shetnehal/Chipalooza_CuriousIC_BMS/presentation/Design review slides of BMS.pptx

## Battery Management System - AFE Design Review

Team CuriousIC

## System Architecture

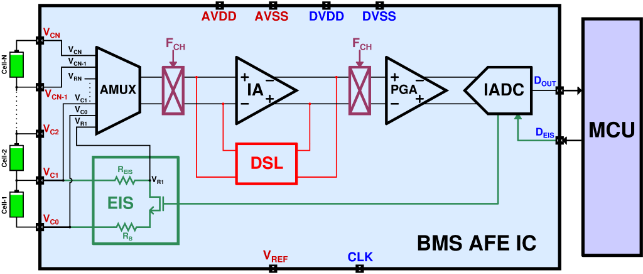
[picture p1: figure]

- Capacitively-Coupled Instrumentation Amplifier (CCIA) { Chopper, DC Servo Loop (DCSL) }
- Incremental Delta-Sigma (DSM) Analog-to-Digital Converter (ADC) { DSM Loop, Clock Generation}

## Top-Level System Schematic

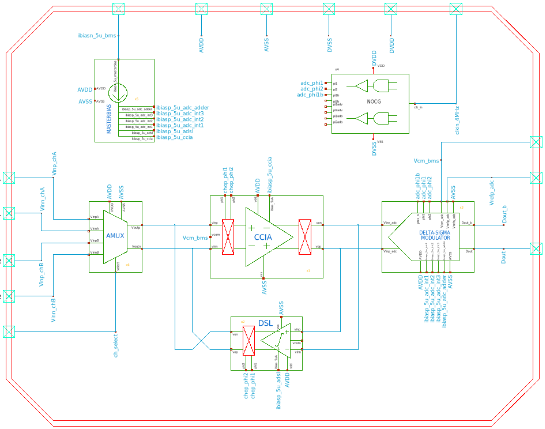
[picture p2: figure]

## ADC Specifications

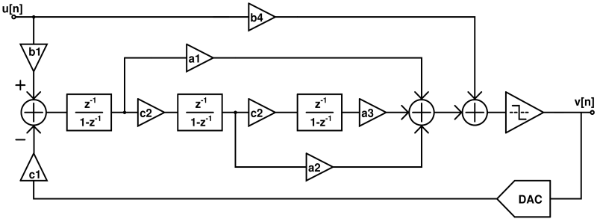
[picture p3: figure]

- Cascade of Integrators with Feed Forward (CIFF) architecture
- State reset after each conversion after each conversion enables sequential multi-cell measurement in BMS AFE

Parameter | Details
Order | 3rd
ENOB | > 16 bits
Sampling Frequency | 4MHz
Signal Bandwidth | 3.9kHz
OSR | 512
Quantizer | 1-bit

## ADC Schematics

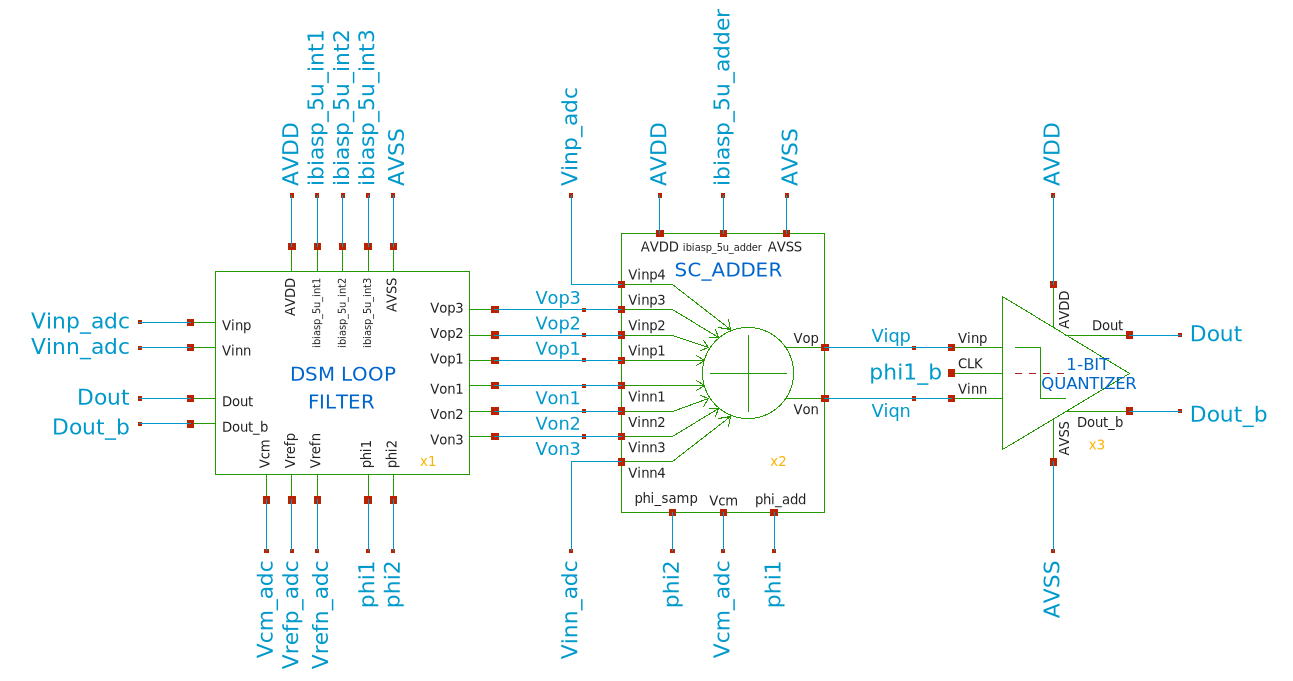
[picture p4: figure]

- The 3rd-order Delta-Sigma ADC employs a cascaded three-stage loop filter.
- A switched-capacitor (SC) analog adder combines the outputs of the integrators.
- A 1-bit quantizer converts the summed analog signal into a digital output.

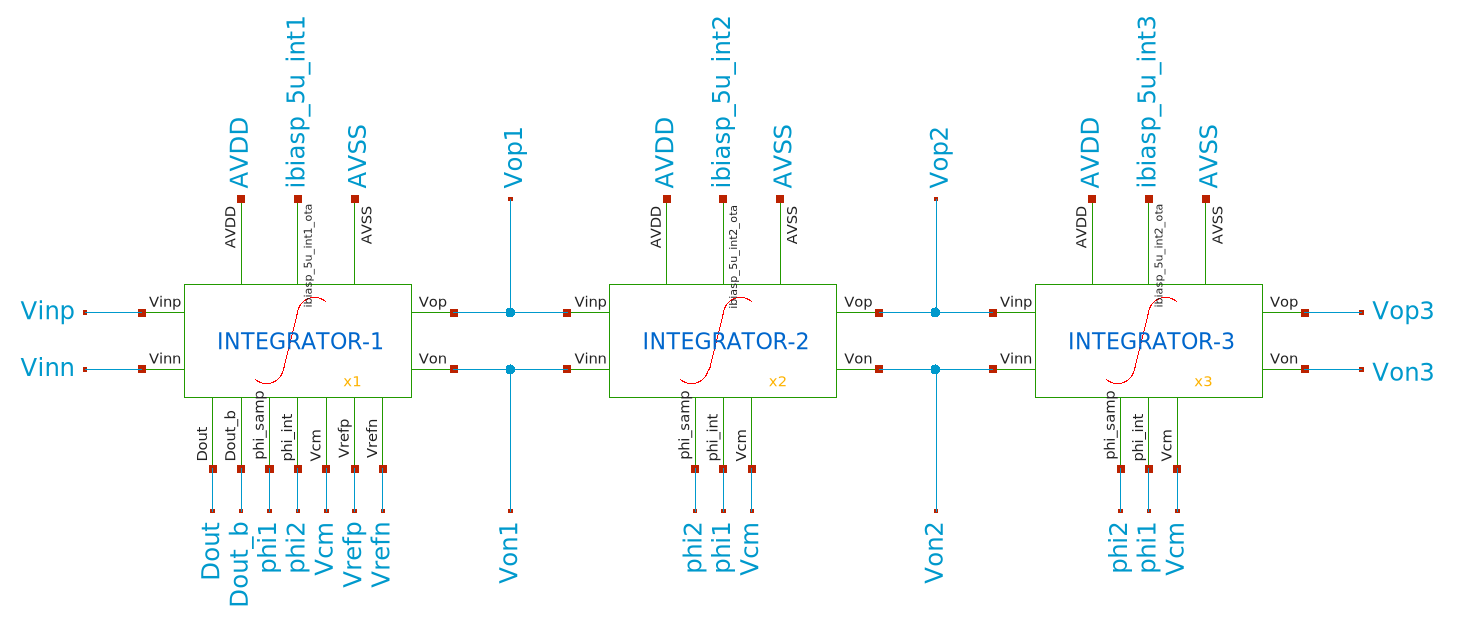
[picture p5: figure]

## ADC Schematics

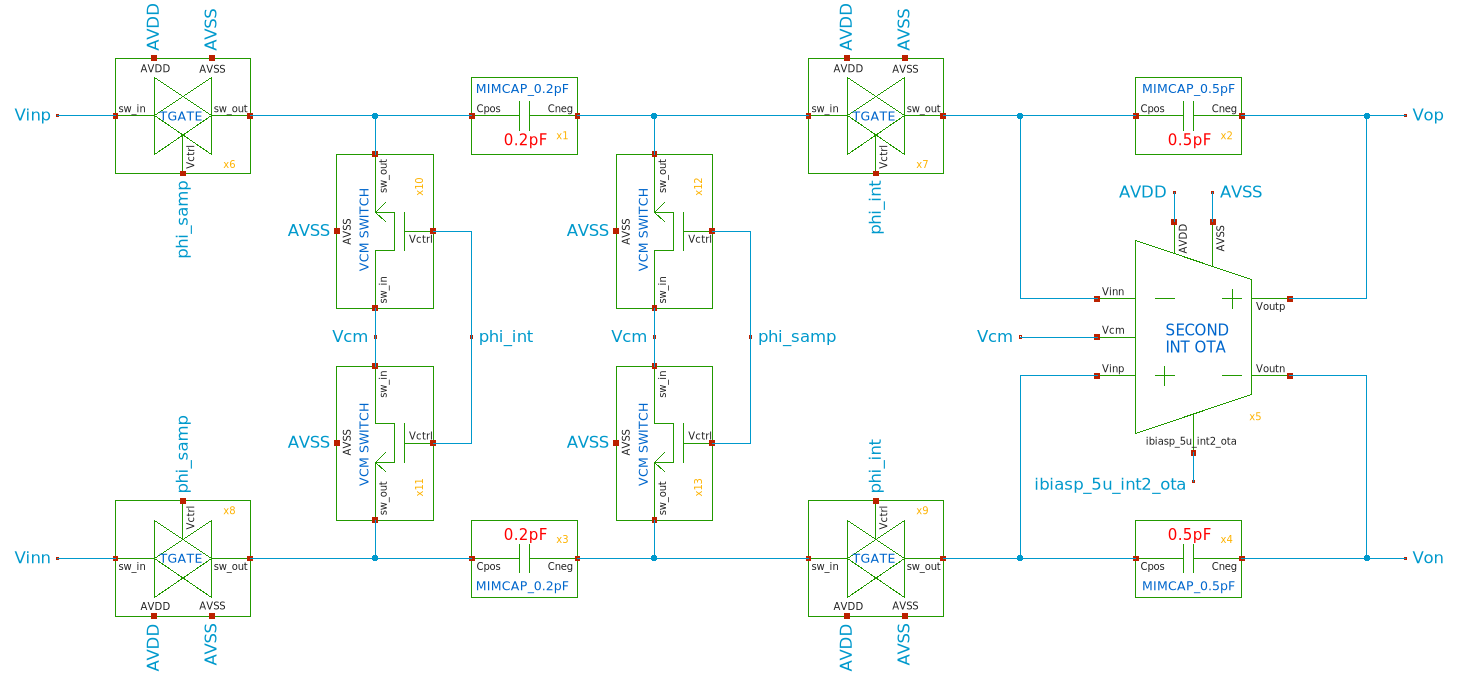
[picture p6: figure]
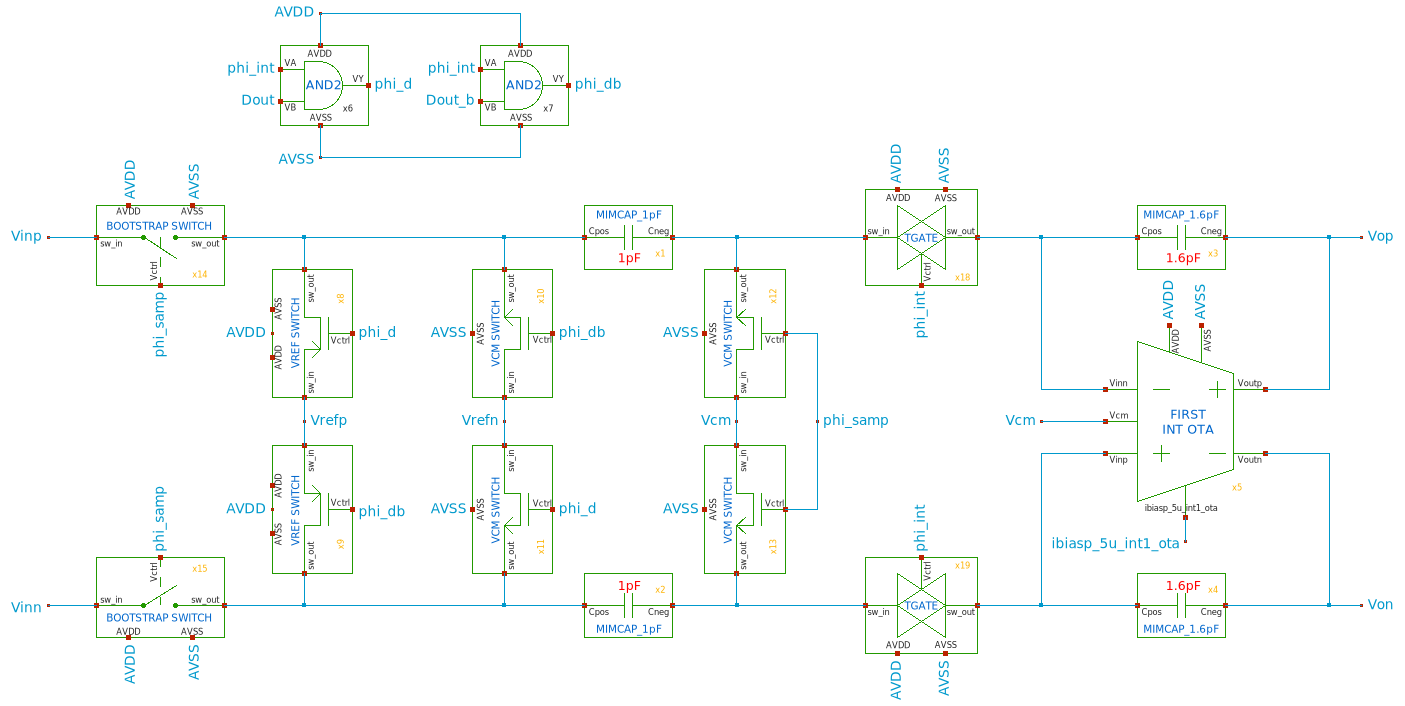
[picture p7: figure]

2nd Integrator

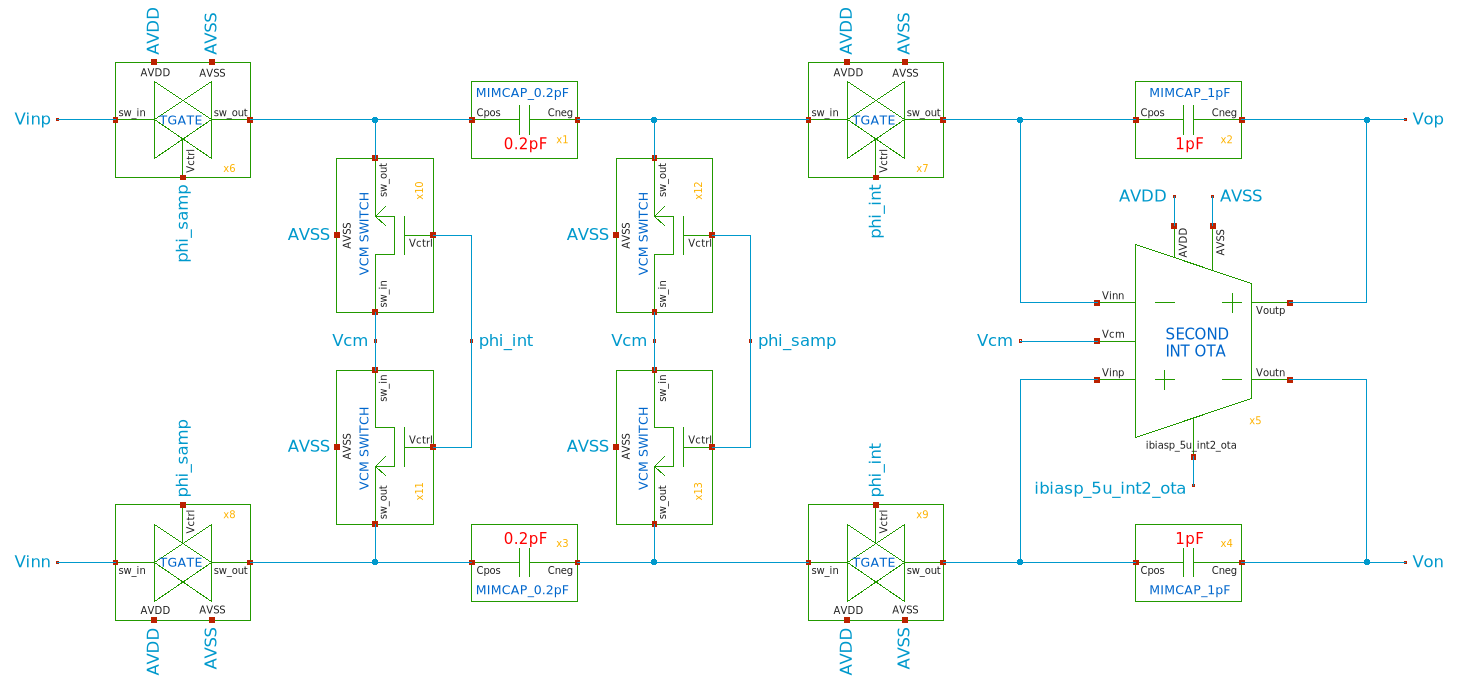
[picture p8: figure]

1st Integrator

3rd Integrator

- Schematics of Integrators used in the DSM Loop Filter

## ADC Schematics

OTA for 2nd Integrator

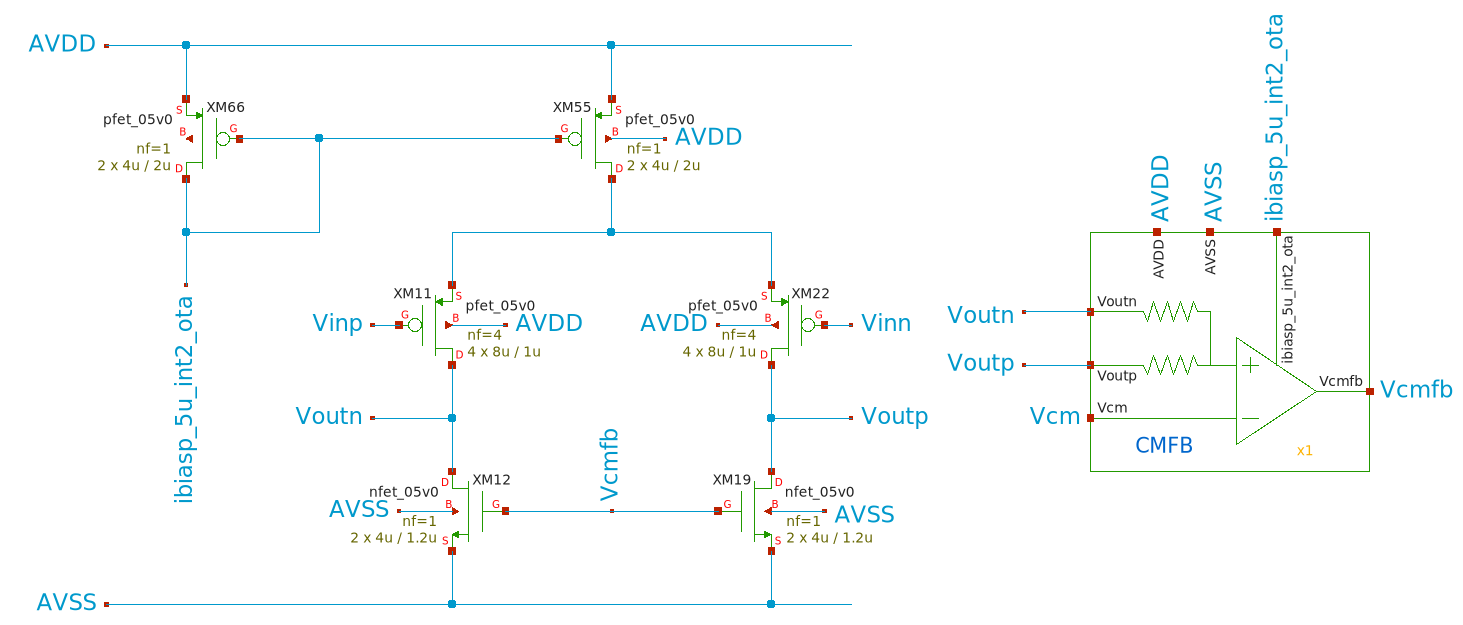
[picture p9: figure]
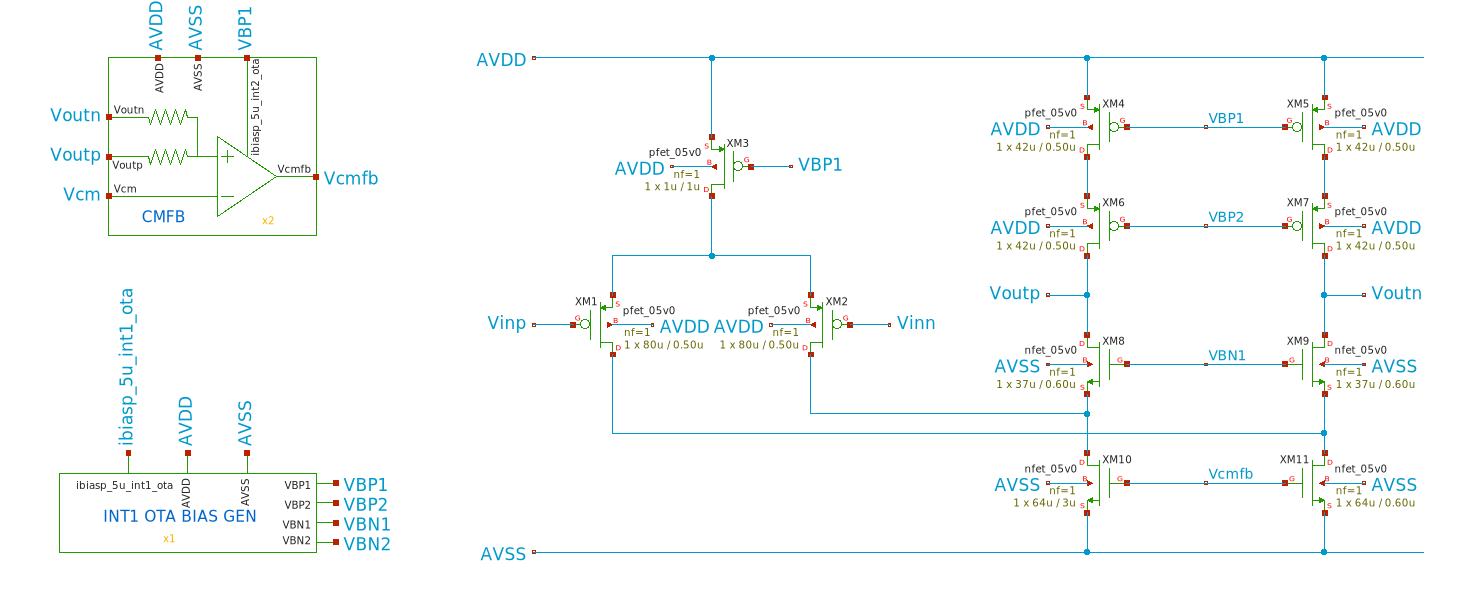
[picture p10: figure]

CMFB circuit for both OTA

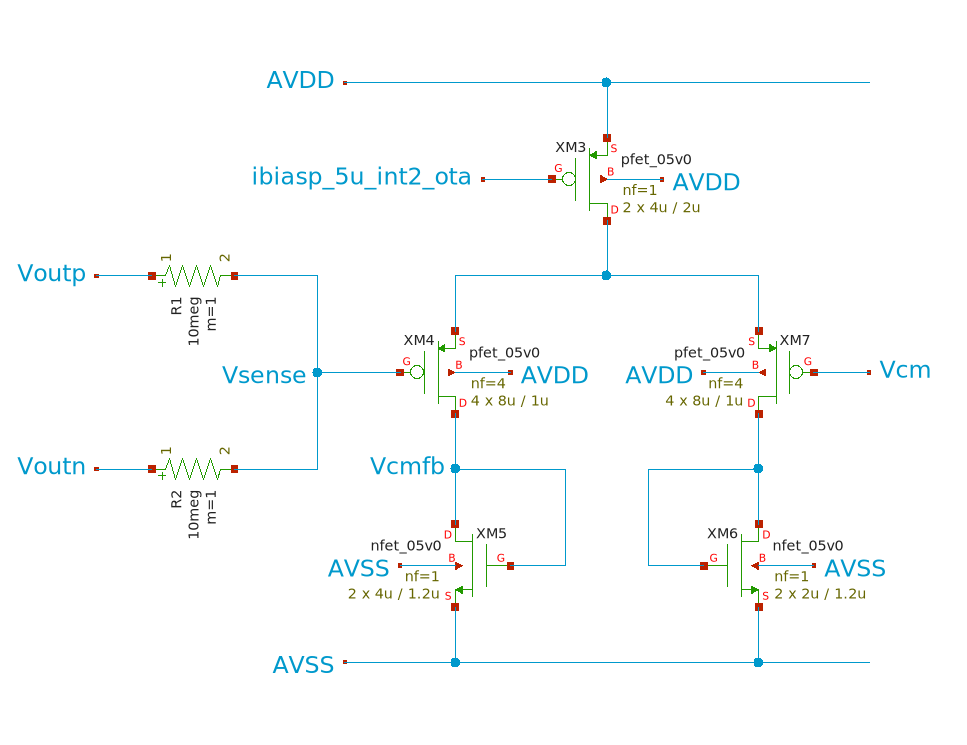
[picture p11: figure]

OTA for 1st Integrator

- Schematics of the OTAs for designing integrators
- Common Mode Feedback (CMFB) is reused for both OTAs

## ADC Simulation Results

1st Integrator Output

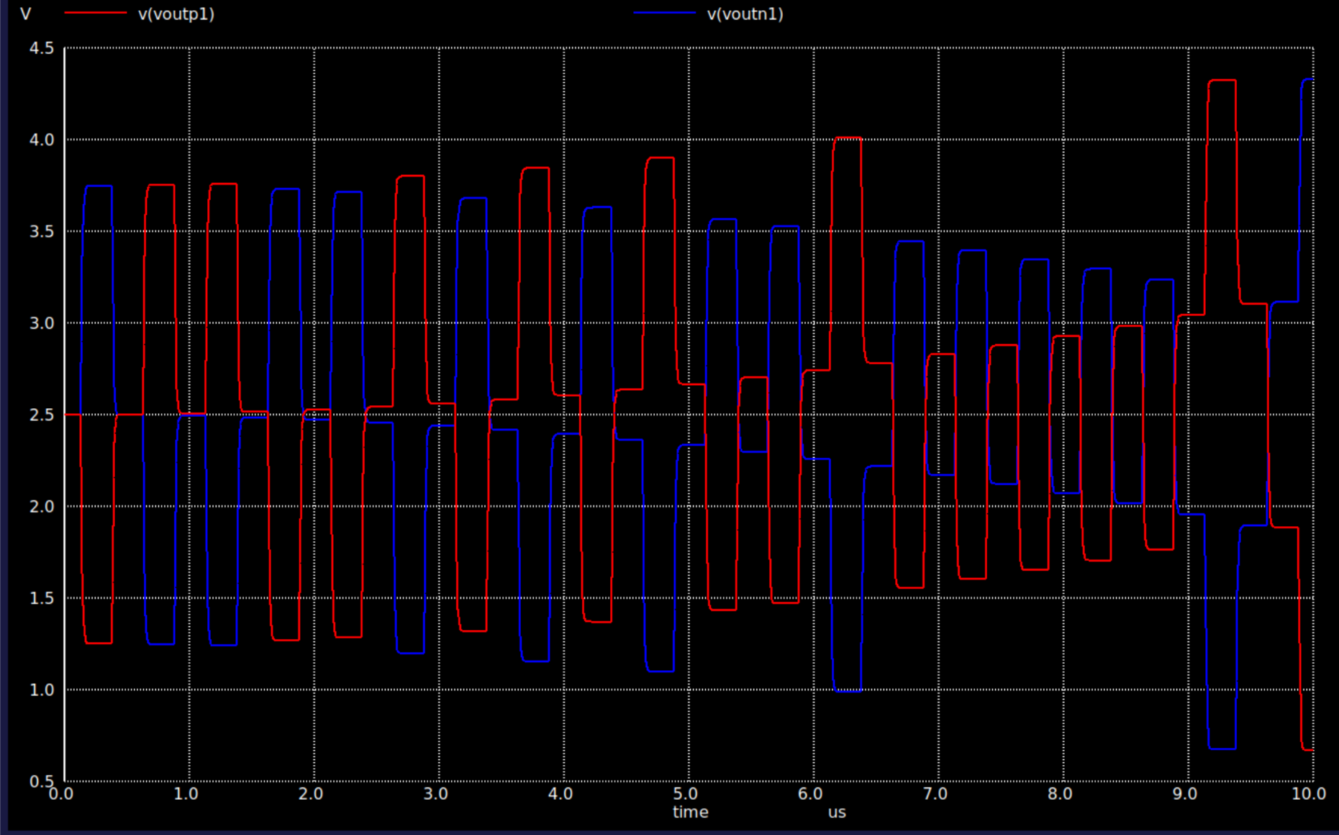
[picture p12: figure]

2nd Integrator Output

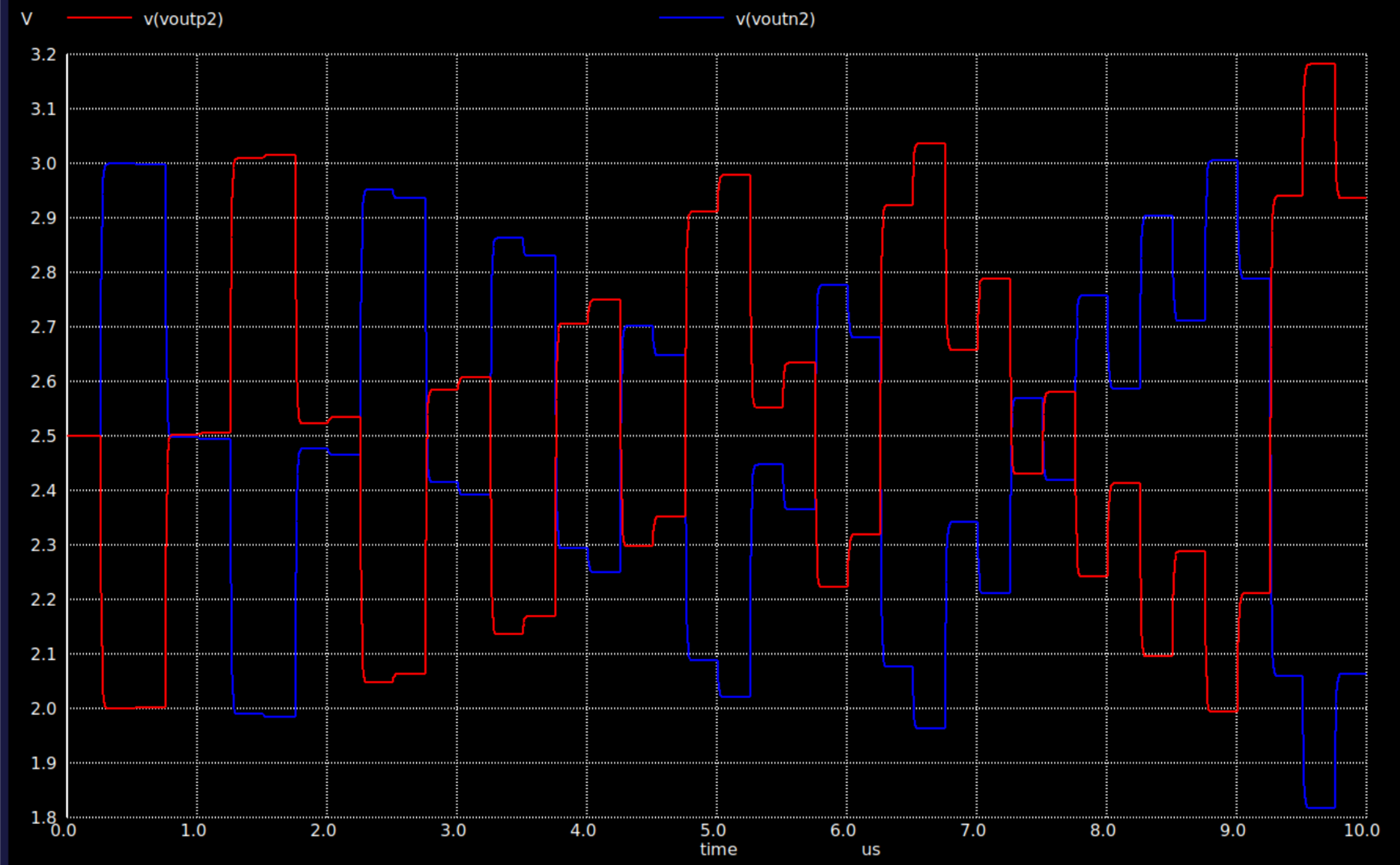
[picture p13: figure]

- The integrator stage outputs exhibit stable bounded behaviour with progressively reduced signal swing across successive stages, indicating proper loop operation and effective higher-order noise shaping

## ADC Simulation Results

3rd Integrator Output

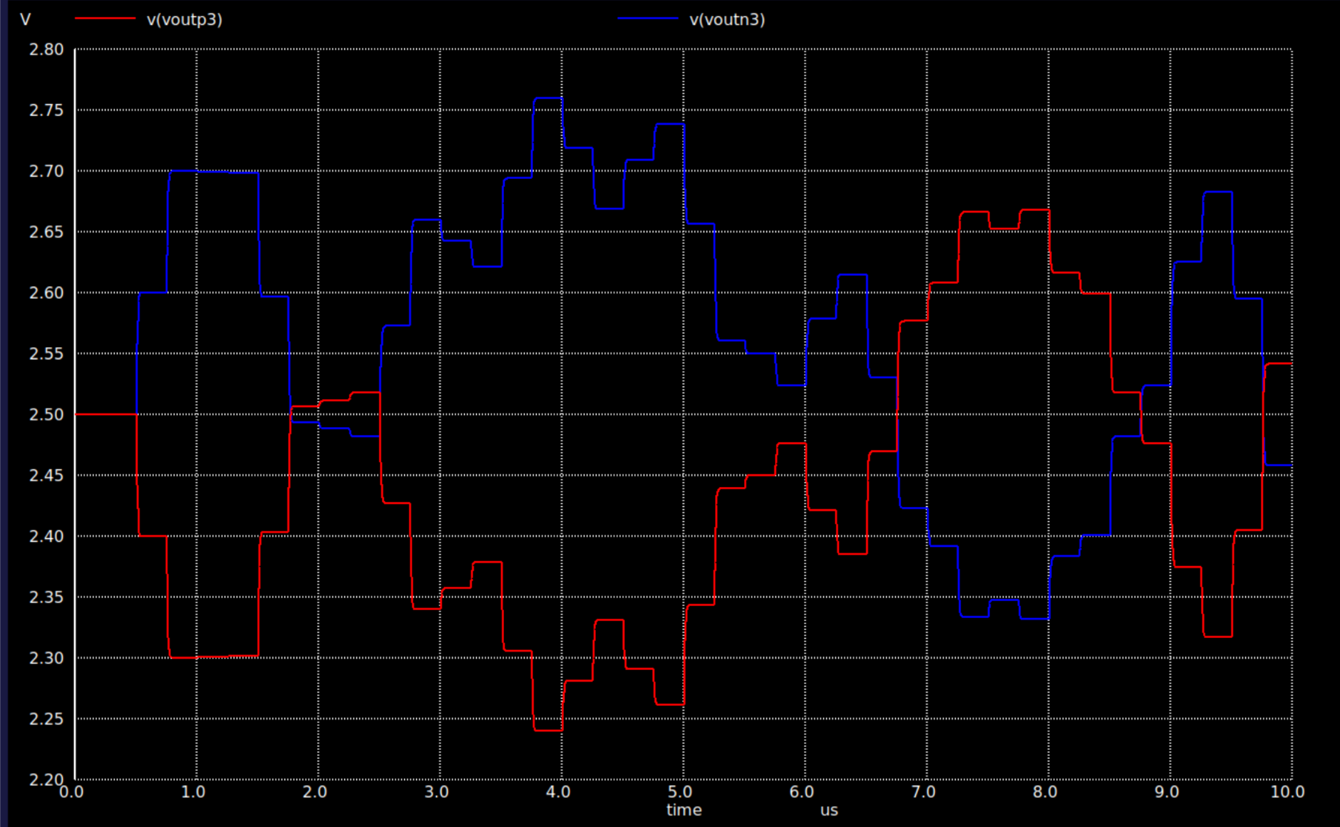
[picture p14: figure]

Quantizer Output

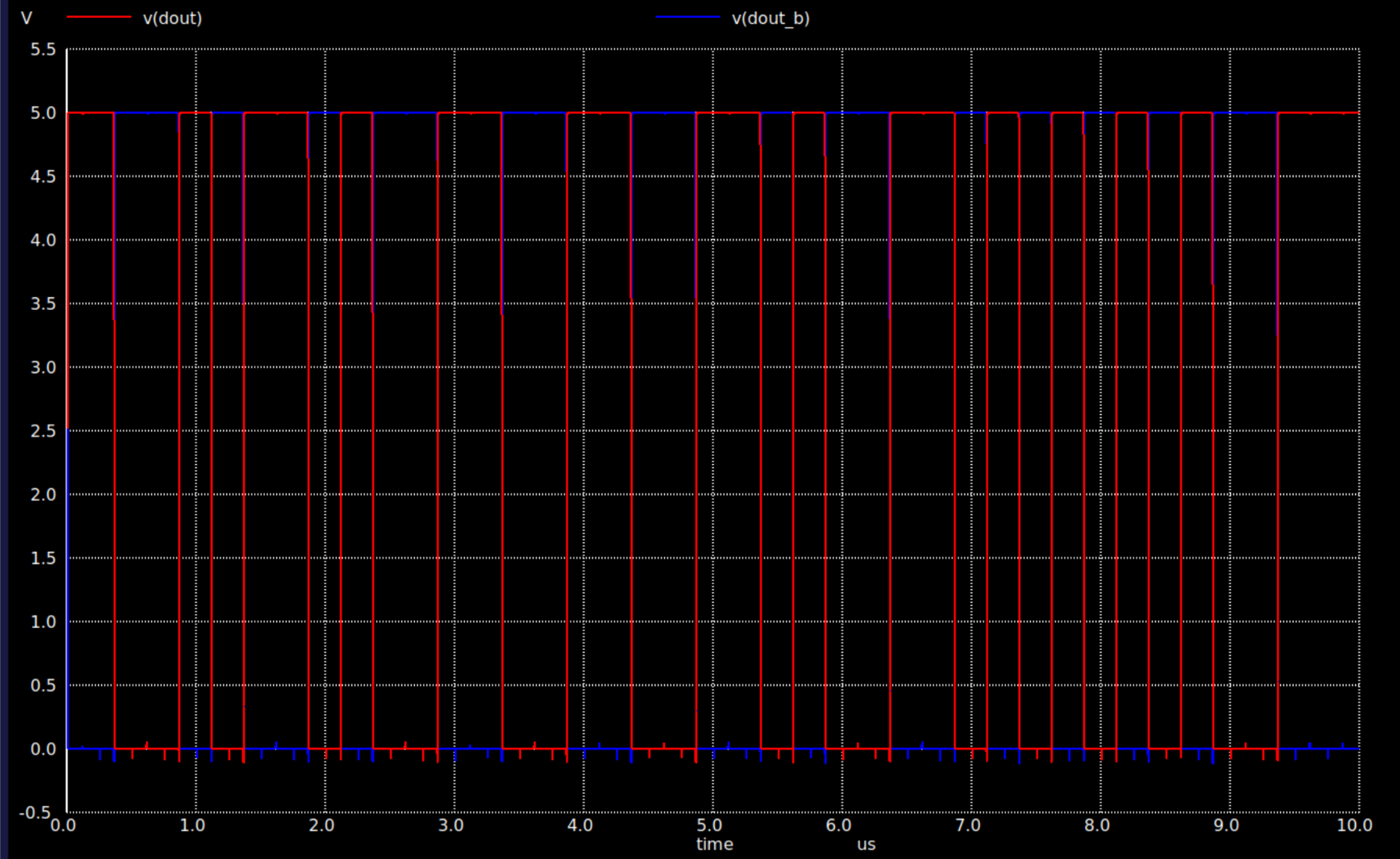
[picture p15: figure]

- The third integrator output remains bounded throughout the simulation, demonstrating stable third-order loop dynamics while accumulating and shaping the quantization error
- The 1-bit quantizer produces a binary bitstream that switches between the two output levels according to the input signal amplitude. The varying pulse density encodes the analog input while enabling high-order noise shaping

## ADC Simulation Results

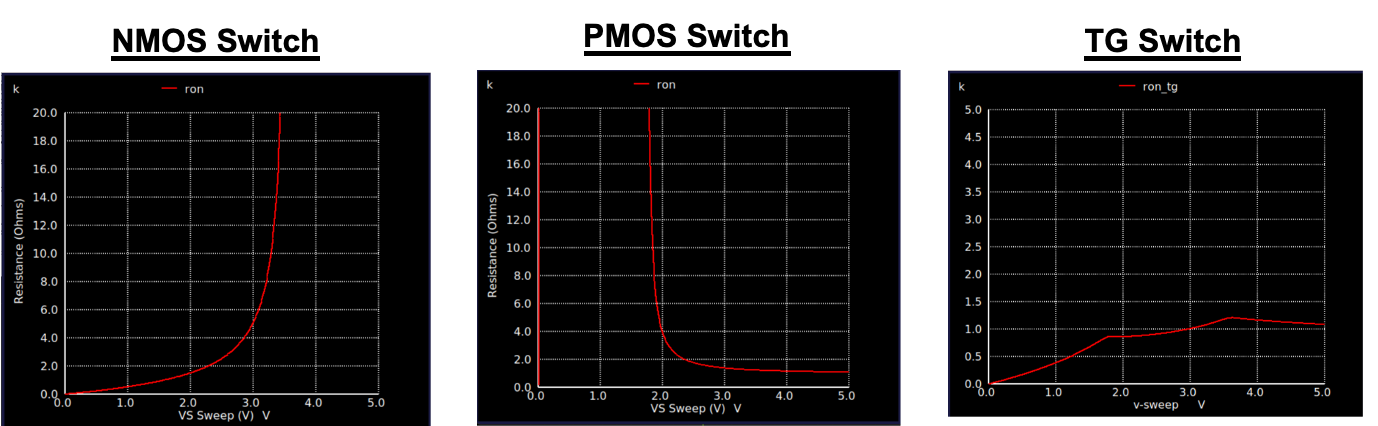
[picture p16: figure]

- NMOS switches are used for the VCM and VREFN paths, while the PMOS switch is used for the VREFP path to provide lower ron and faster settling
- Transmission Gate (TG) switches are employed in the signal path to achieve a nearly constant and low ON resistance over the full input voltage range
- The simulated Ron characteristics shown above verify the appropriate switch selection, ensuring low resistance, improved linearity, and accurate switched-capacitor operation

## ADC Simulation Results

ADC Output Spectrum

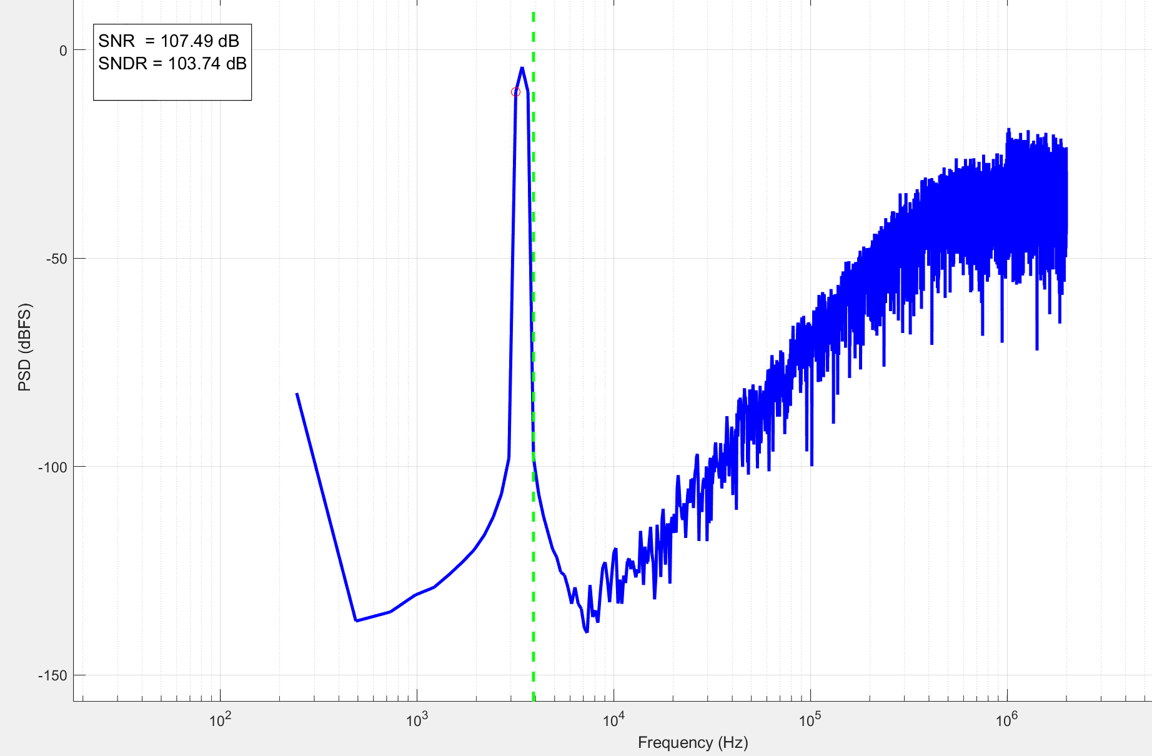
[picture p17: figure]

- The FFT spectrum shows a prominent fundamental component at the input frequency and effective high-frequency quantization noise shaping characteristic of a third-order ΔΣ modulator. The achieved SNR of 107.49 dB and SNDR of 103.74 dB validate the proposed ADC architecture.

## CCIA Specification

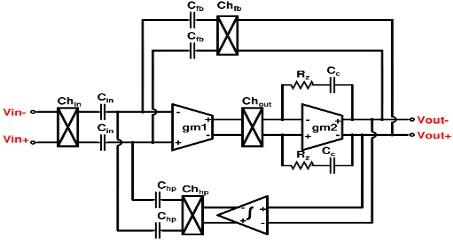
[picture p18: figure]

Parameter | Details
Current | 100uA
OCV/EIS Gain | 1/100 V/V
Chopping Frequency | 5kHz
Zin | 30MΩ
Offset Voltage | 1uV
Noise (0.1-10 Hz) | 10uVrms
CMRR | >100dB
PSRR | >90dB

- Capacitive coupling for blocking large DC common mode (CM), high common mode rejection ratio (CMRR), and accurate closed-loop gain
- Chopper stabilized for offset and noise cancellation

## CCIA Schematics

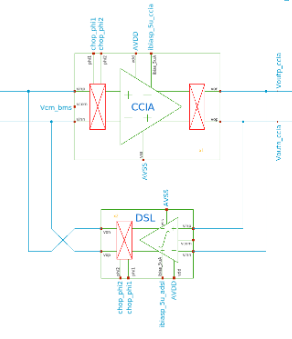
[picture p19: figure]

- Top level schematic of CCIA

## CCIA Schematics

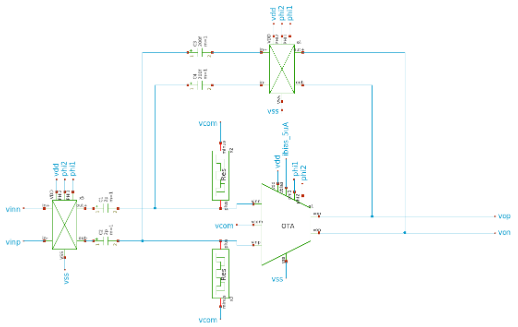
[picture p20: figure]

- Schematic of instrumentation amplifier

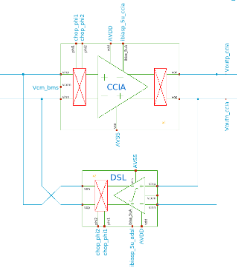
[picture p21: figure]

## CCIA Schematics

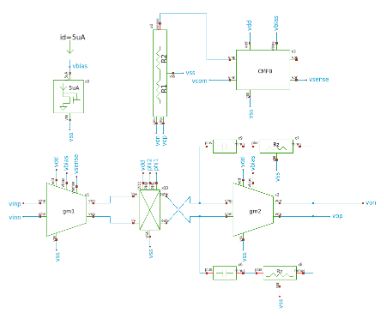
[picture p22: figure]
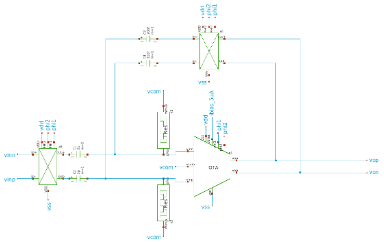
[picture p23: figure]

- Differential opamp with chopper and CMFB circuit

## CCIA Schematics

gm1

gm2

CMFB

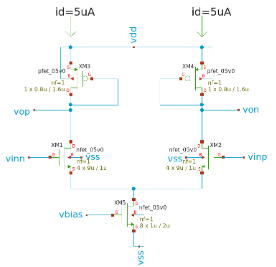
[picture p24: figure]
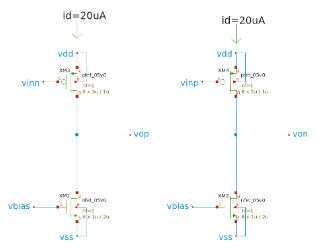
[picture p25: figure]
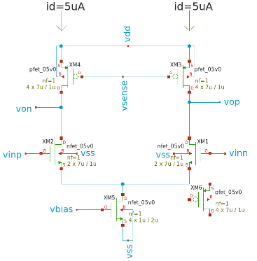
[picture p26: figure]

- Transistor level schematic of gm1, gm2 and CMFB stages for the instrumentation amplifier

## CCIA Schematics

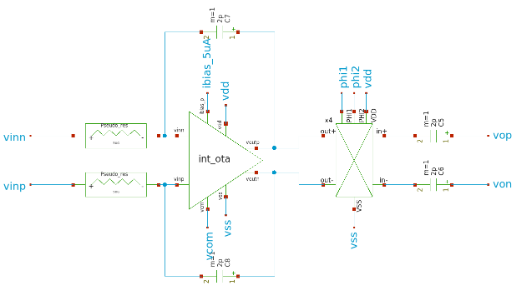
[picture p27: figure]

- Top level schematic of DC servo loop

## CCIA Schematics

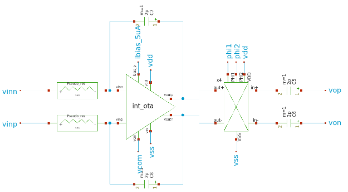
[picture p28: figure]
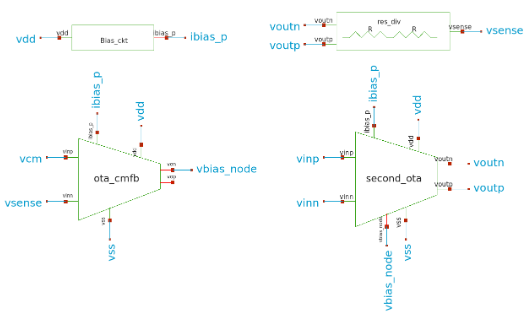
[picture p29: figure]

- Schematic of the OTA used for the DSL integrator

## CCIA Schematics

gm1

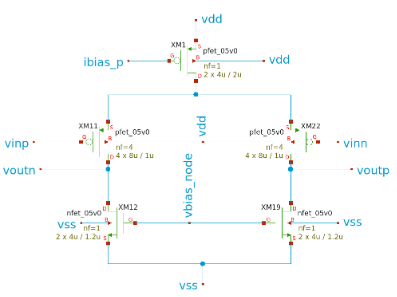
[picture p30: figure]
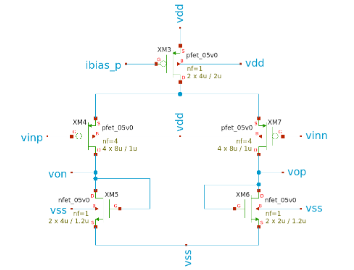
[picture p31: figure]

- Transistor level schematic of the OTA and CMFB

## CCIA AC response

EIS mode

OCV mode

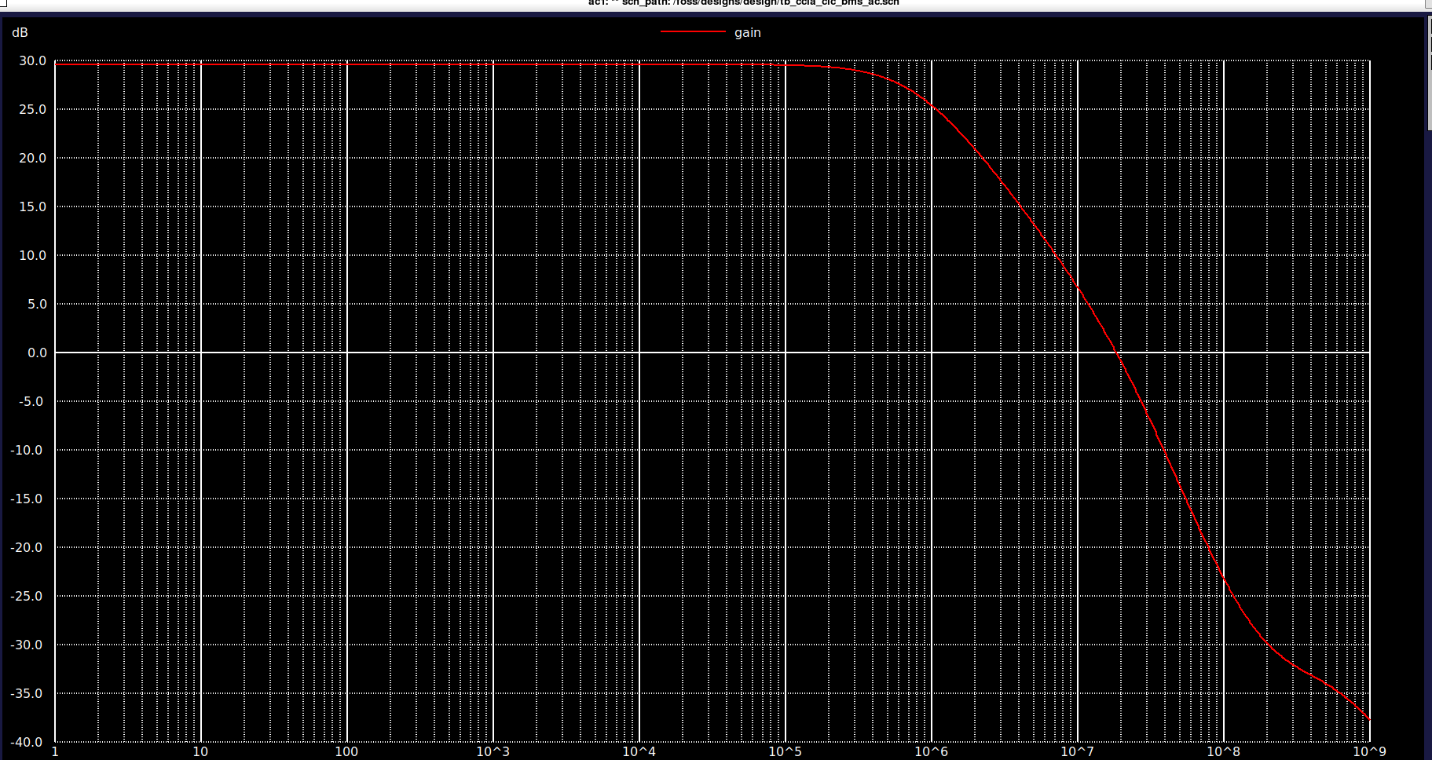
[picture p32: figure]
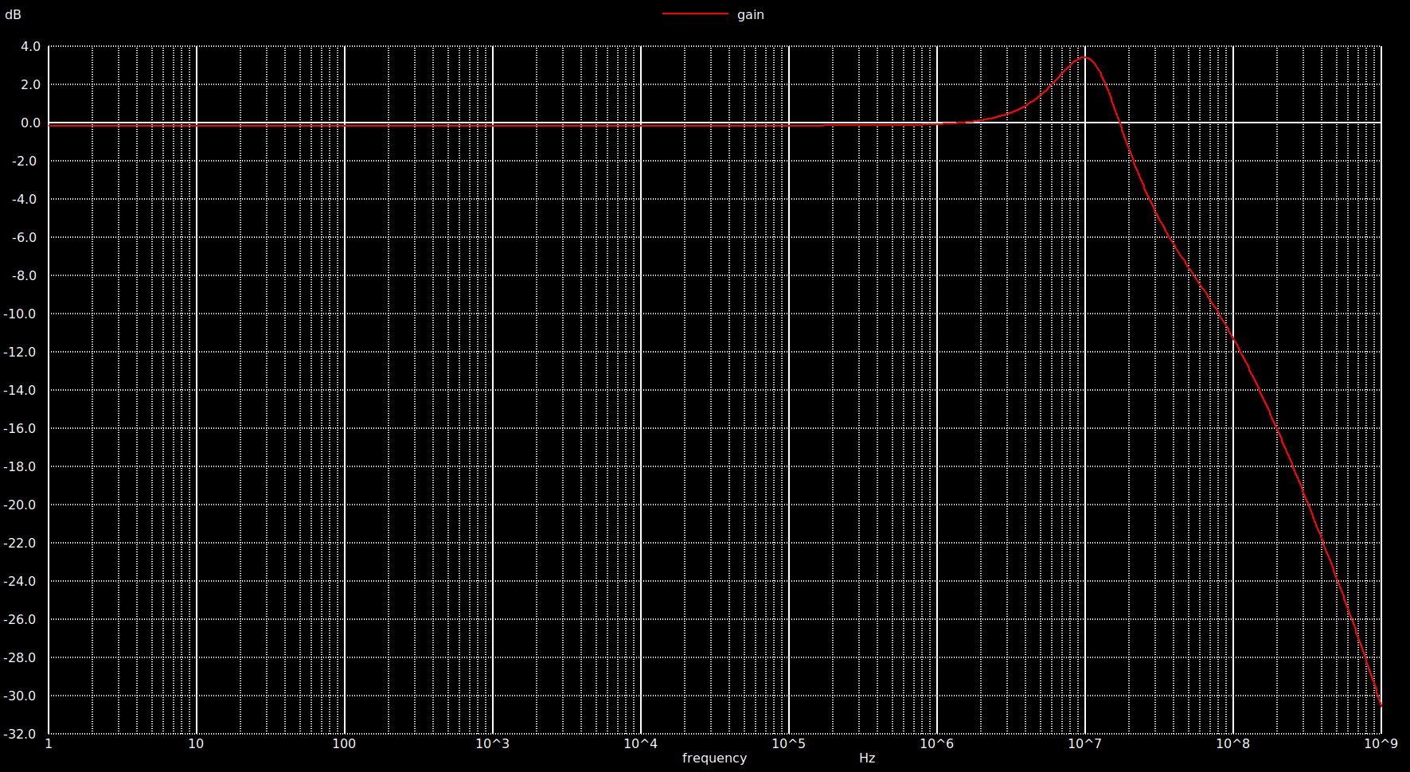
[picture p33: figure]

- Achieved EIS mode gain of 30dB and OCV mode gain of 0dB

## CCIA CMRR analysis

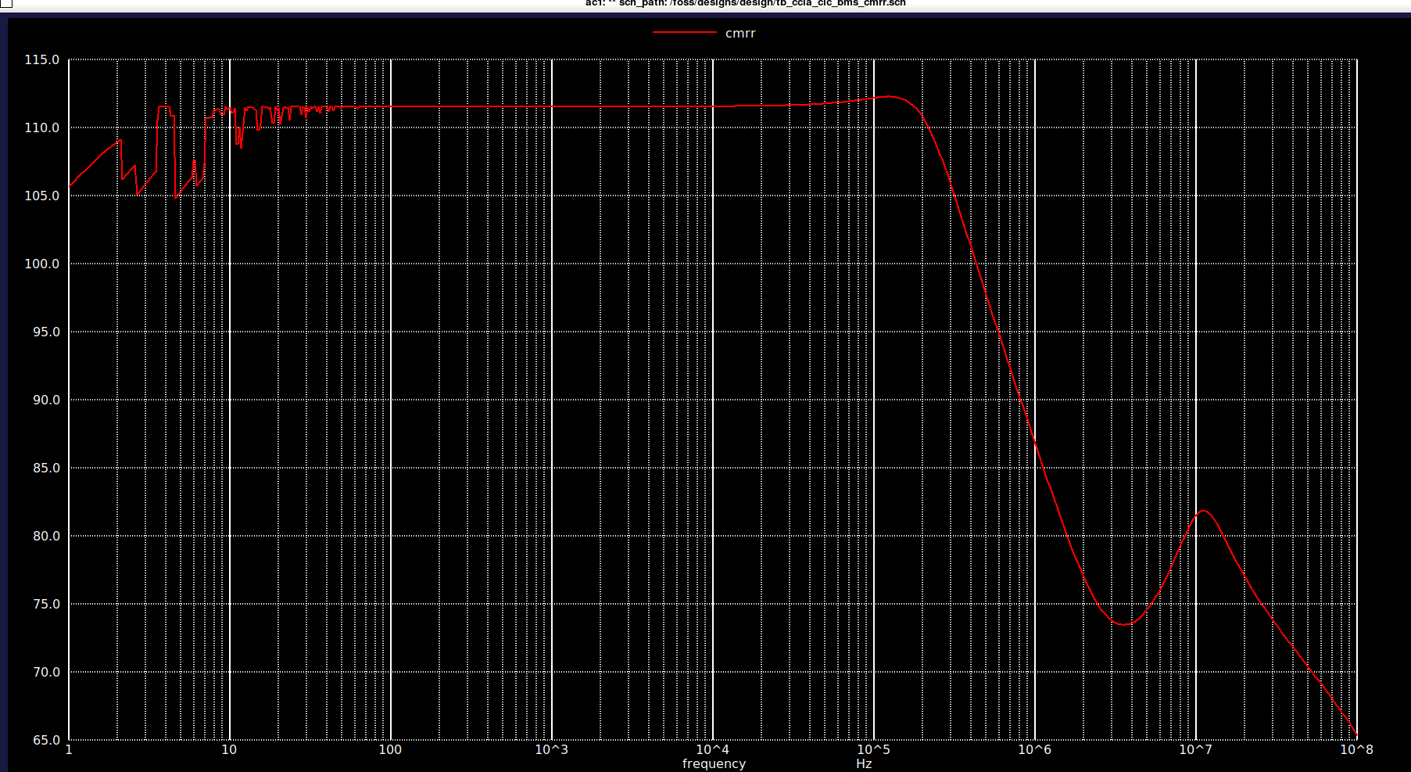
[picture p34: figure]

- Achieved CMRR above 112dB at 100Hz

## CCIA PSRR analysis

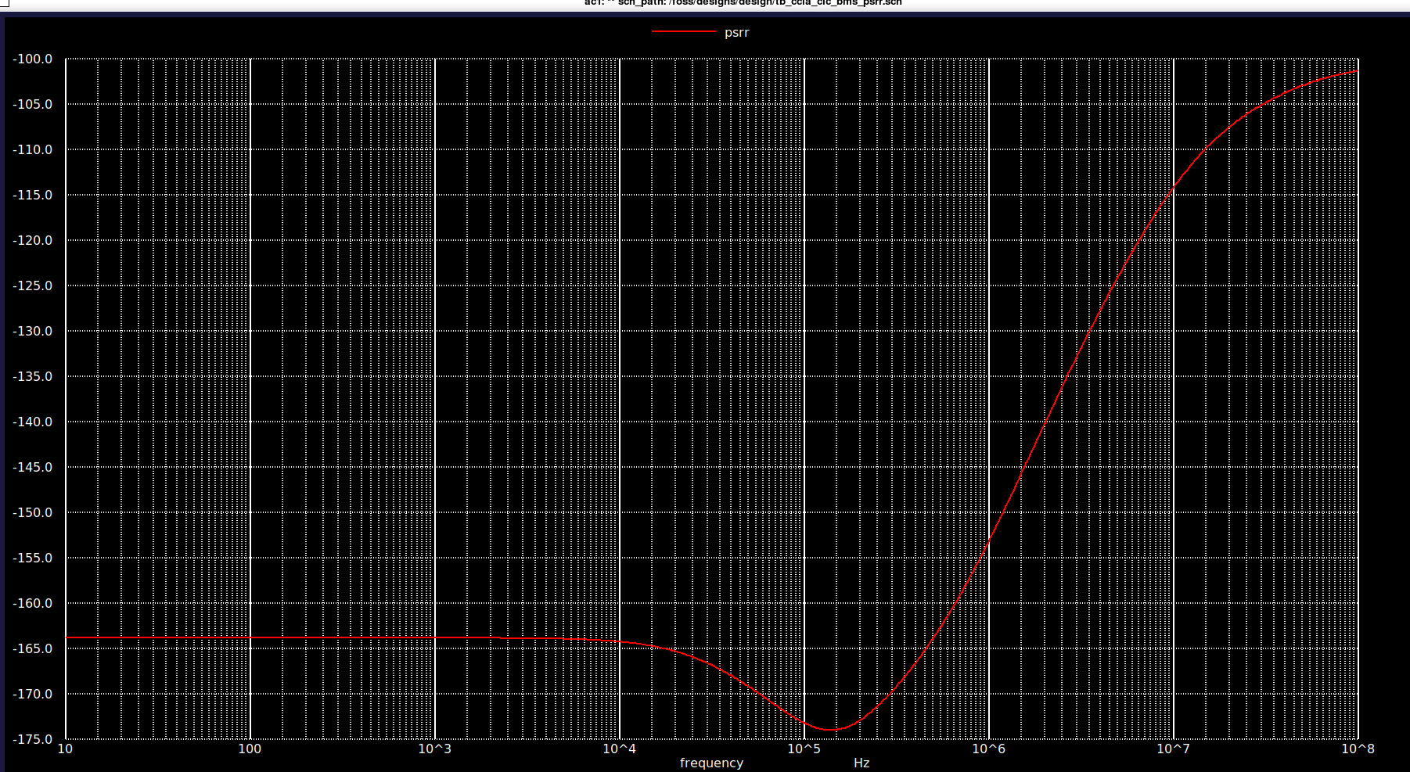
[picture p35: figure]

- Achieved PSRR above 164dB at 100Hz

## Slide 23

EIS Architecture

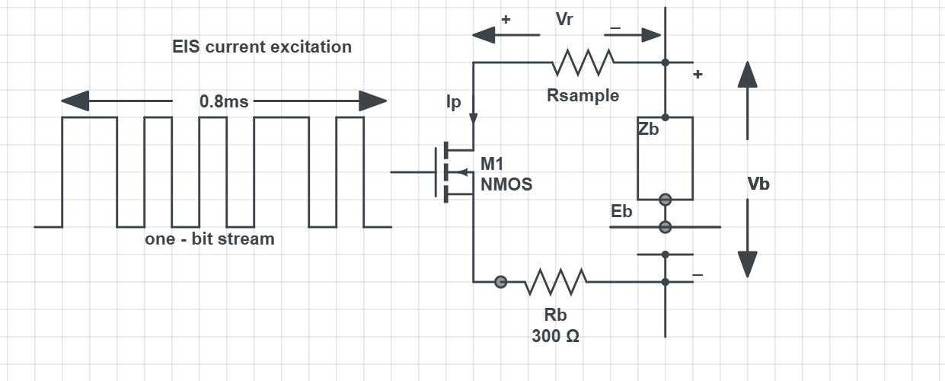
[picture p36: figure]

- The DAC generates smooth, precise analog sine waves to inject controlled AC excitation signals into biological or battery tissue.

## EIS TestBench Schematic

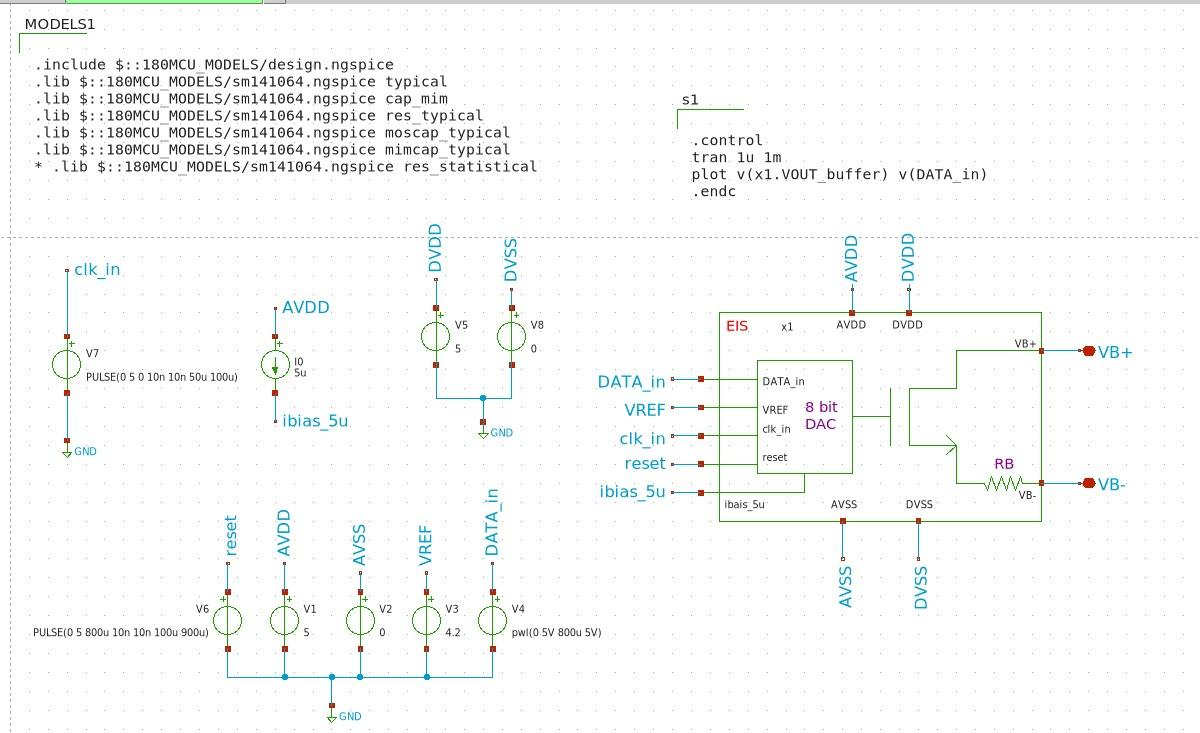
[picture p37: figure]

Vref = 4.2V
Clk period = 100us

Li battery is connected across VB+ and VB-

## Top level schematic of EIS

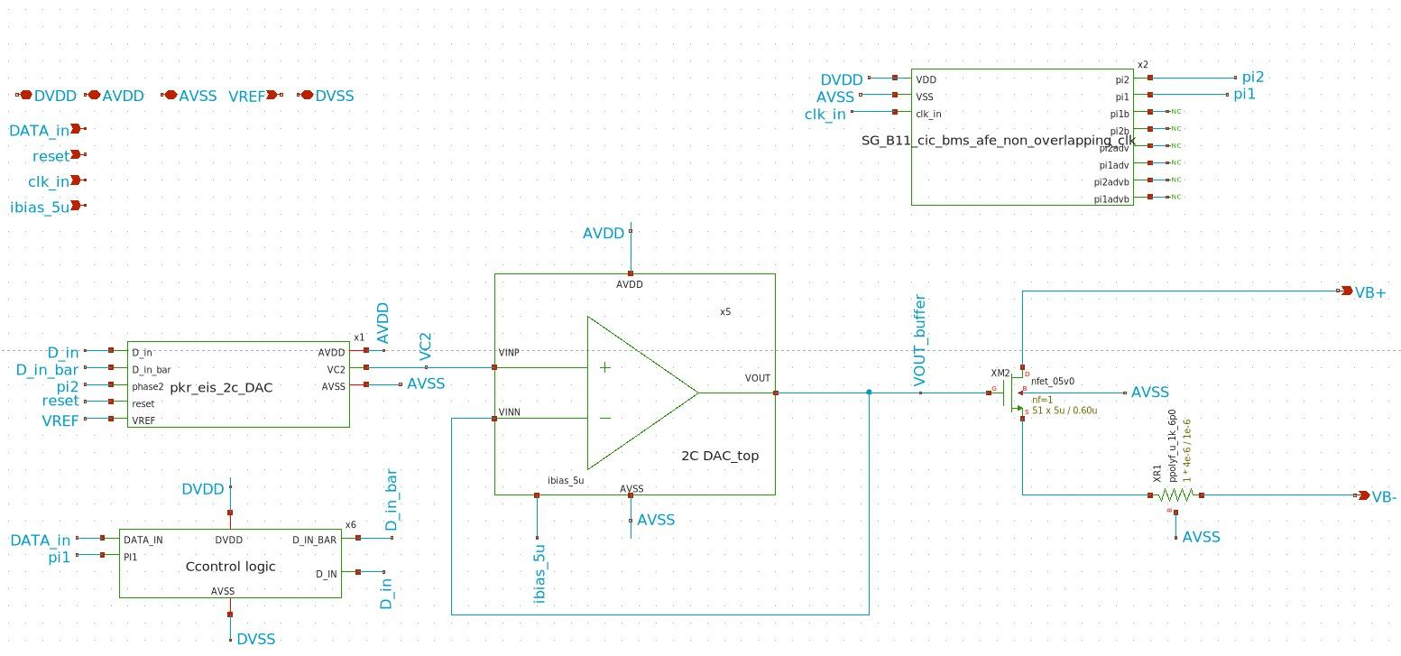
[picture p38: figure]
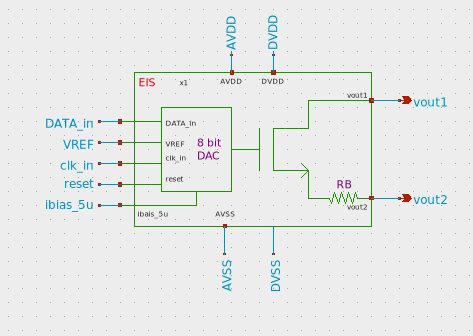
[picture p39: figure]

Excitation current = 10 - 15 mA

## Slide 26

2C - DAC Schematics

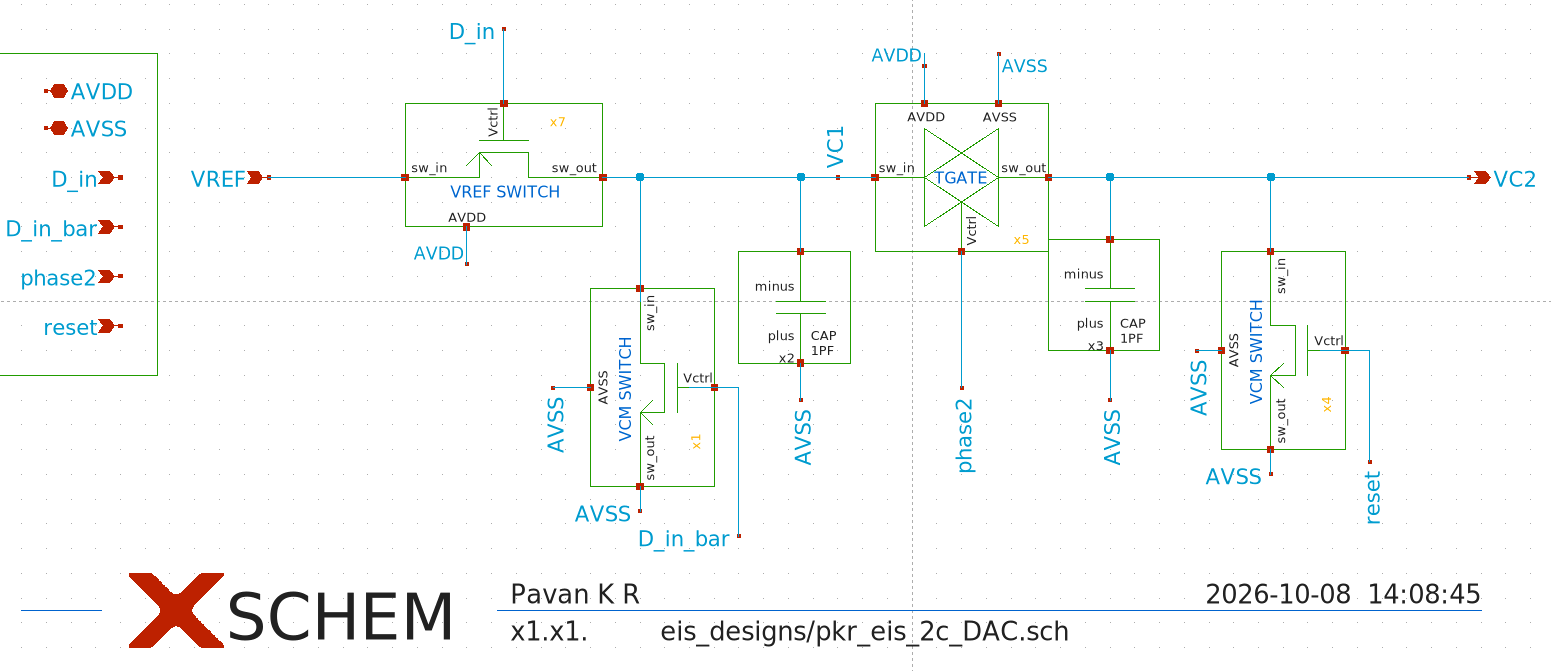
[picture p40: figure]

C1 = C2 = 1pF

## Slide 27

Buffer schematic

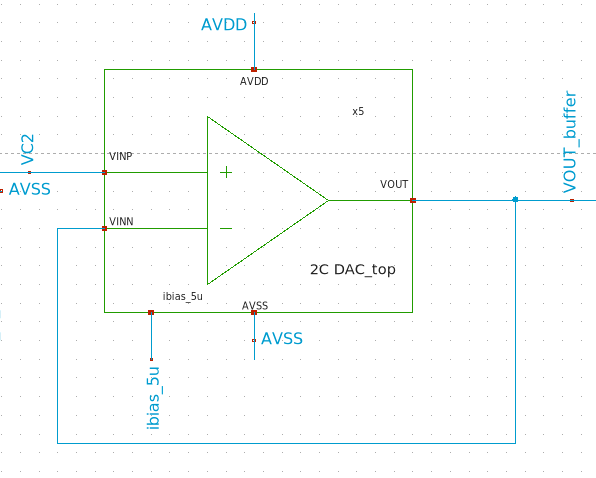
[picture p41: figure]
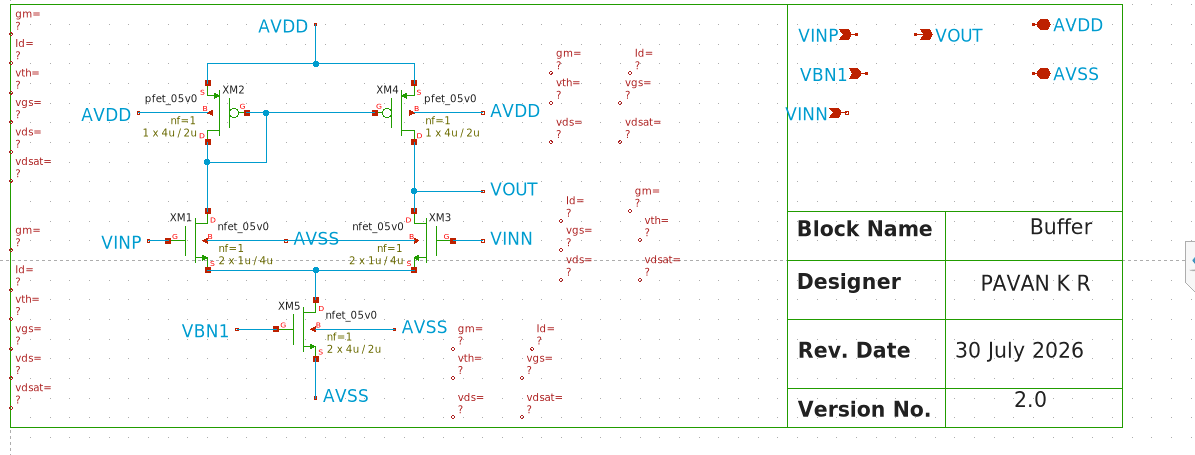
[picture p42: figure]

Intrinsic gain = 50db
UGB = 2.5MHz

## Simulation result

Code (LSB-MSB) | Expected value (V) | simulated Value (V) | Error (V)
00000000 | 0 | 0.1 | +0.1
11111111 | 4.2 | 4.192 | -0.008
00000001 | 2.1 | 2.115 | +0.015
10101010 | 1.395 | 1.41 | -0.015
01010101 | 2.789 | 2.807 | +0.018
00001111 | 3.938 | 3.949 | +0.011

VLSB = Vref = 4.2 = 0.0164V
2^N 2^8

## Slide 29

Simulation plots

DATA_in=11111111 , Vout=4.2V

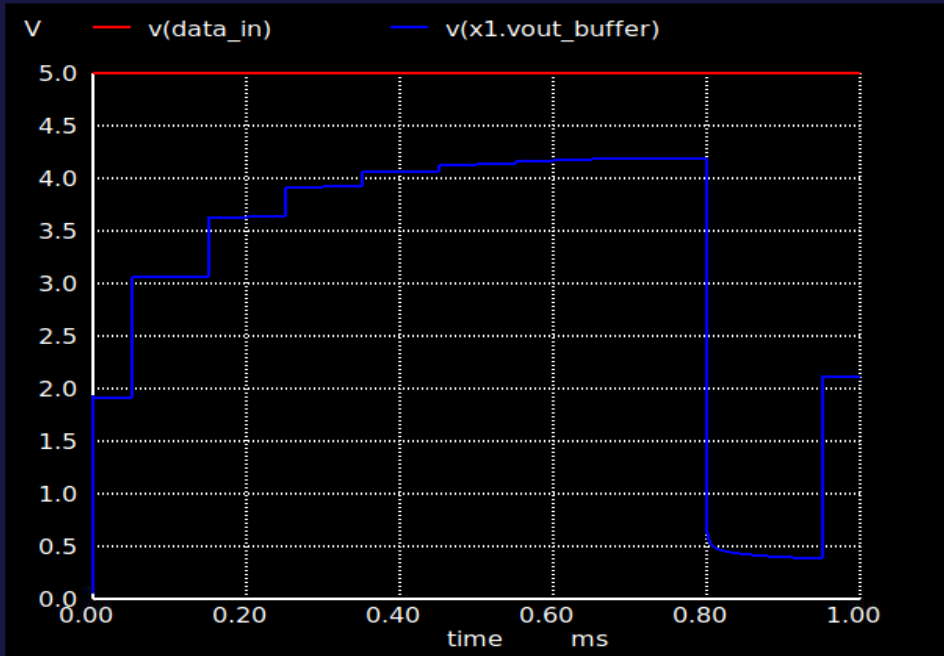
[picture p43: figure]

DATA_in=00000001 , Vout=2.1V

DATA_in=00000000 , Vout=0V

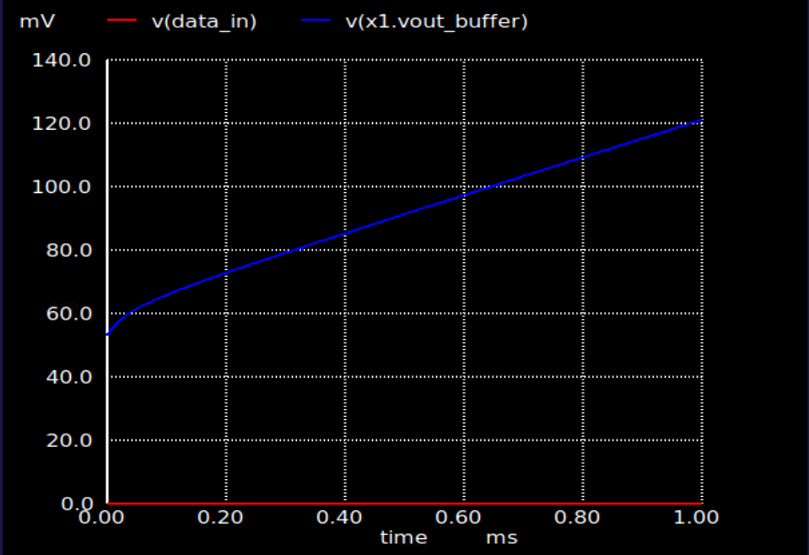
[picture p44: figure]
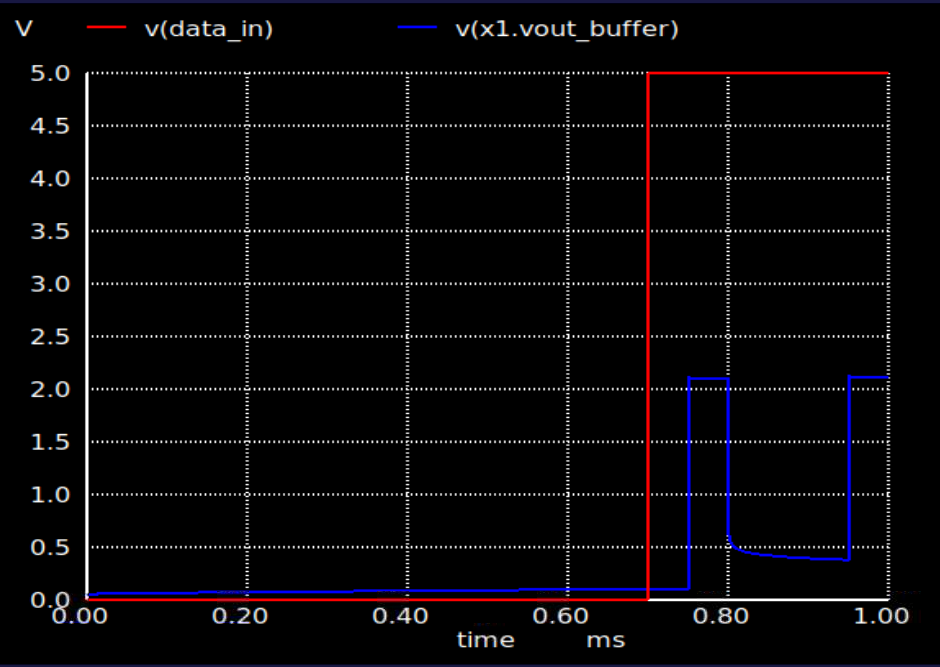
[picture p45: figure]

DATA_in=10101010 , Vout=1.41V

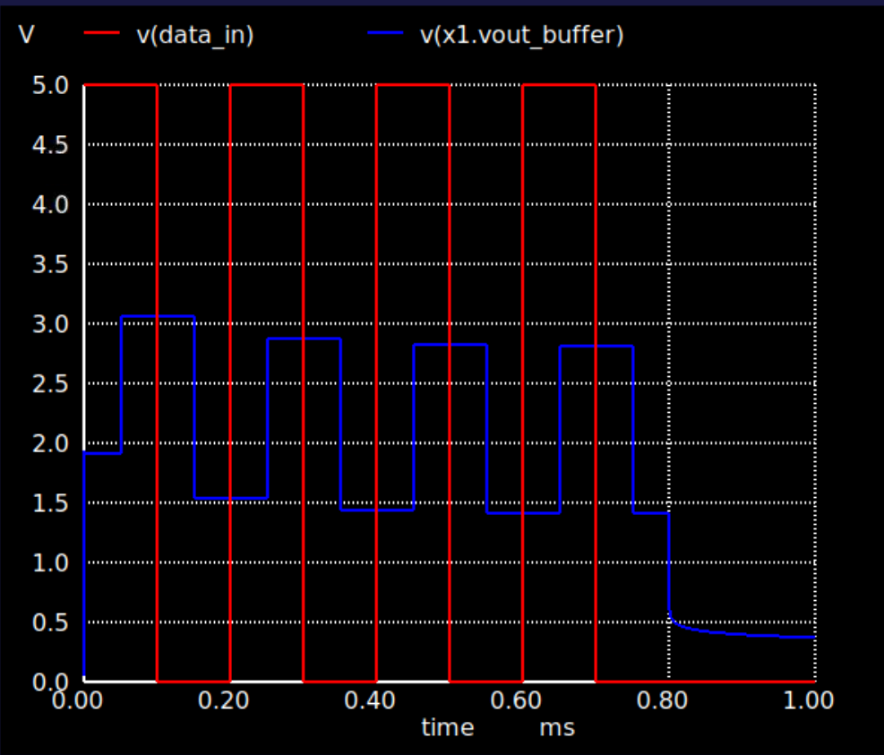
[picture p46: figure]

*LSB- >MSB

## Simulation plots

DATA_in=00001111 , Vout= 0.394V

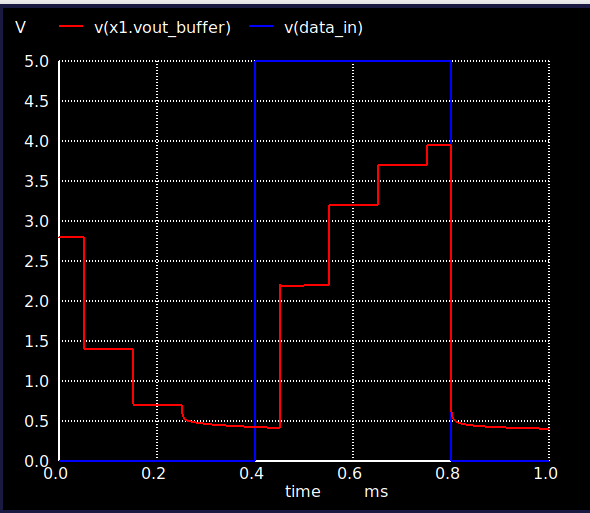
[picture p47: figure]

DATA_in=11110000 , Vout= 0.41V

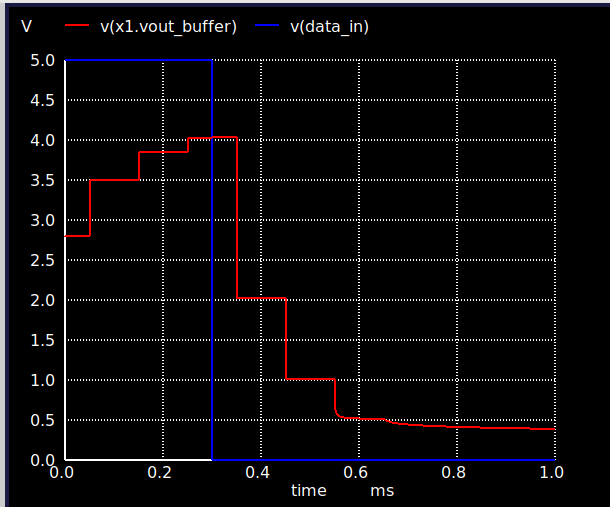
[picture p48: figure]

## test case of generating Sine wave

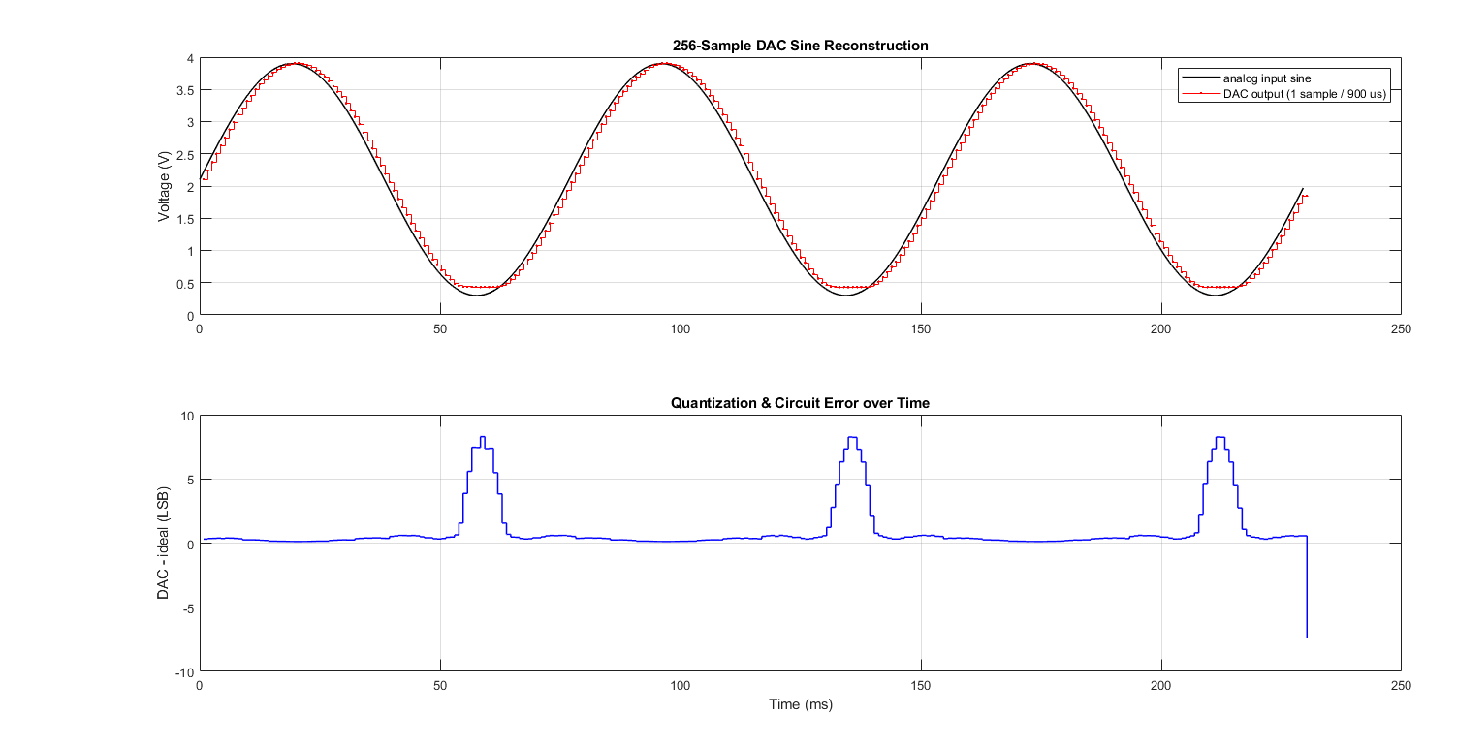
[picture p49: figure]
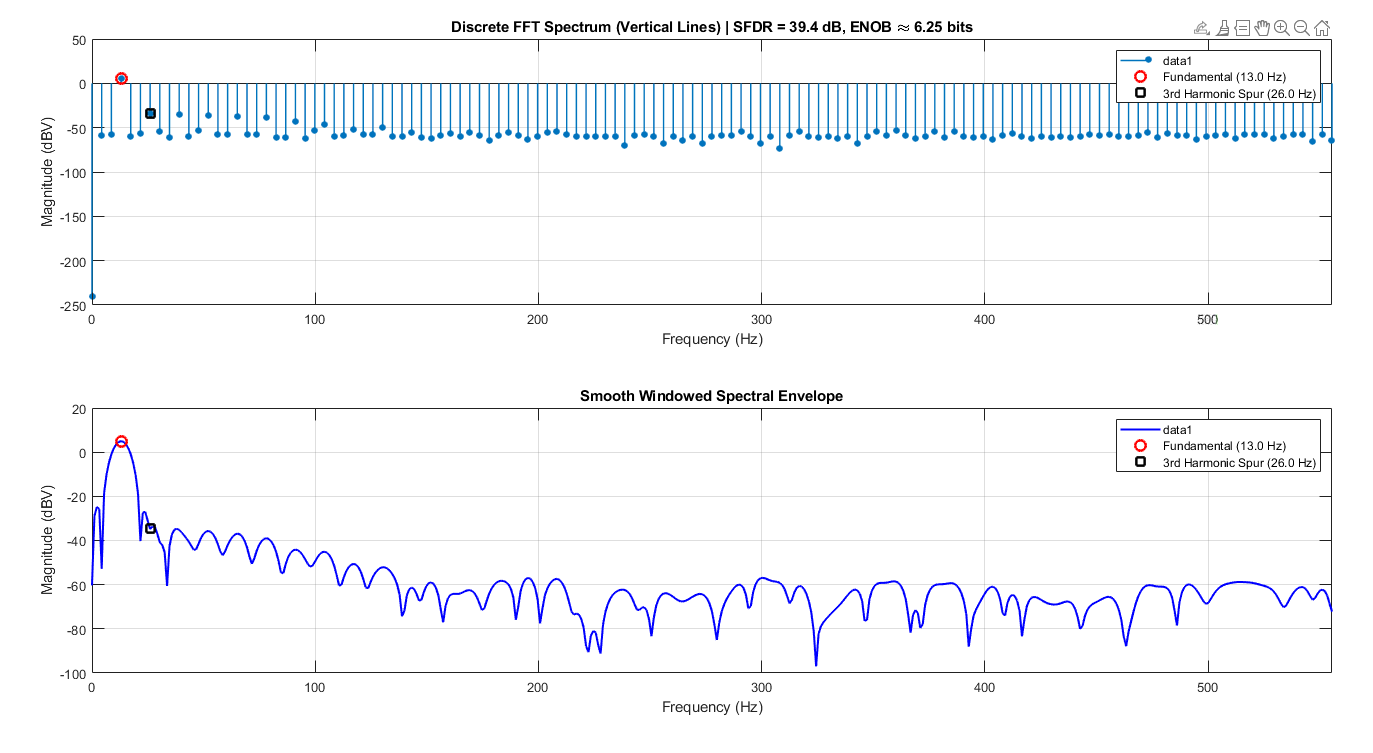
[picture p50: figure]

## Design Specifications for Opamp

No. | Parameter | Value
1. | DC Open Loop Gain | >70dB
2. | Unity Gain Bandwidth | >30MHz
3. | Phase Margin | >60̊
4. | VDD | 5V
5. | Input Bias Current | 5uA

## Opamp Schematic

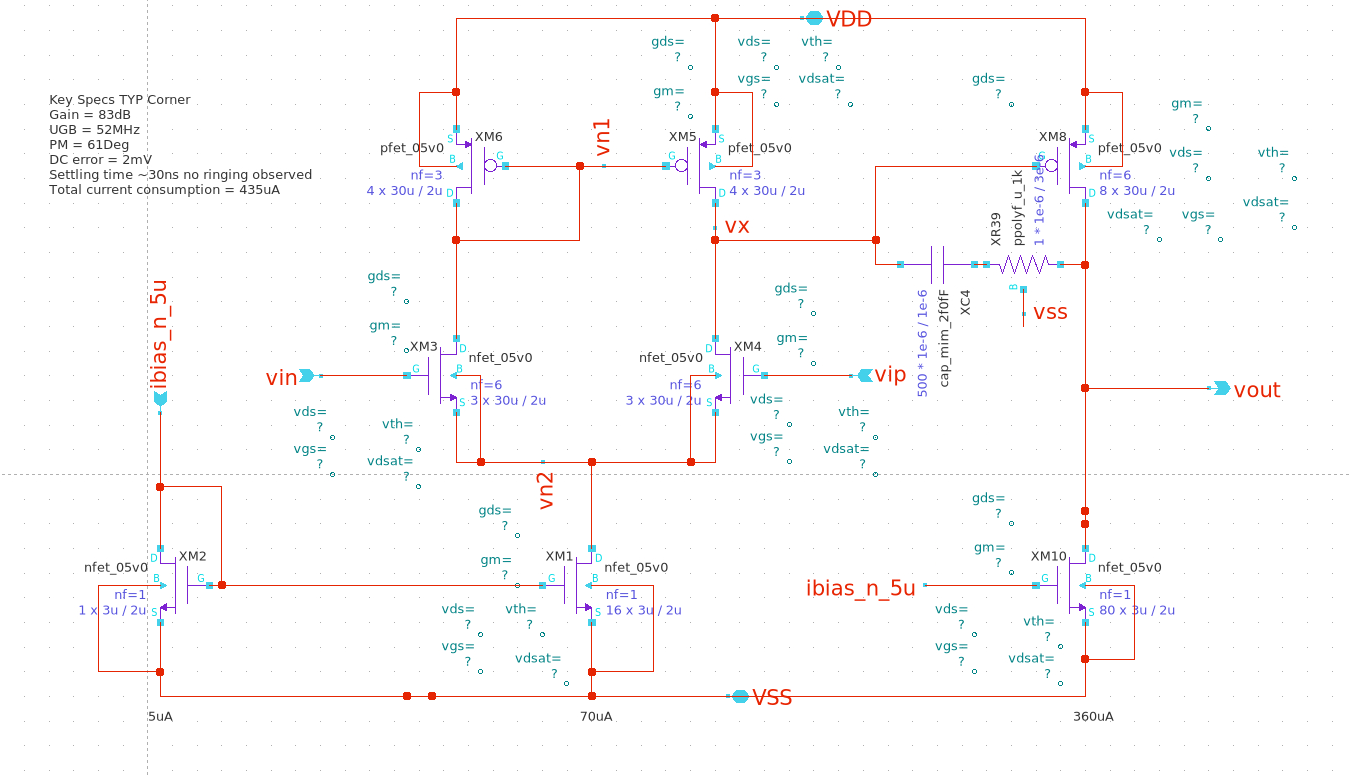
[picture p51: figure]

## Open Loop Testbench

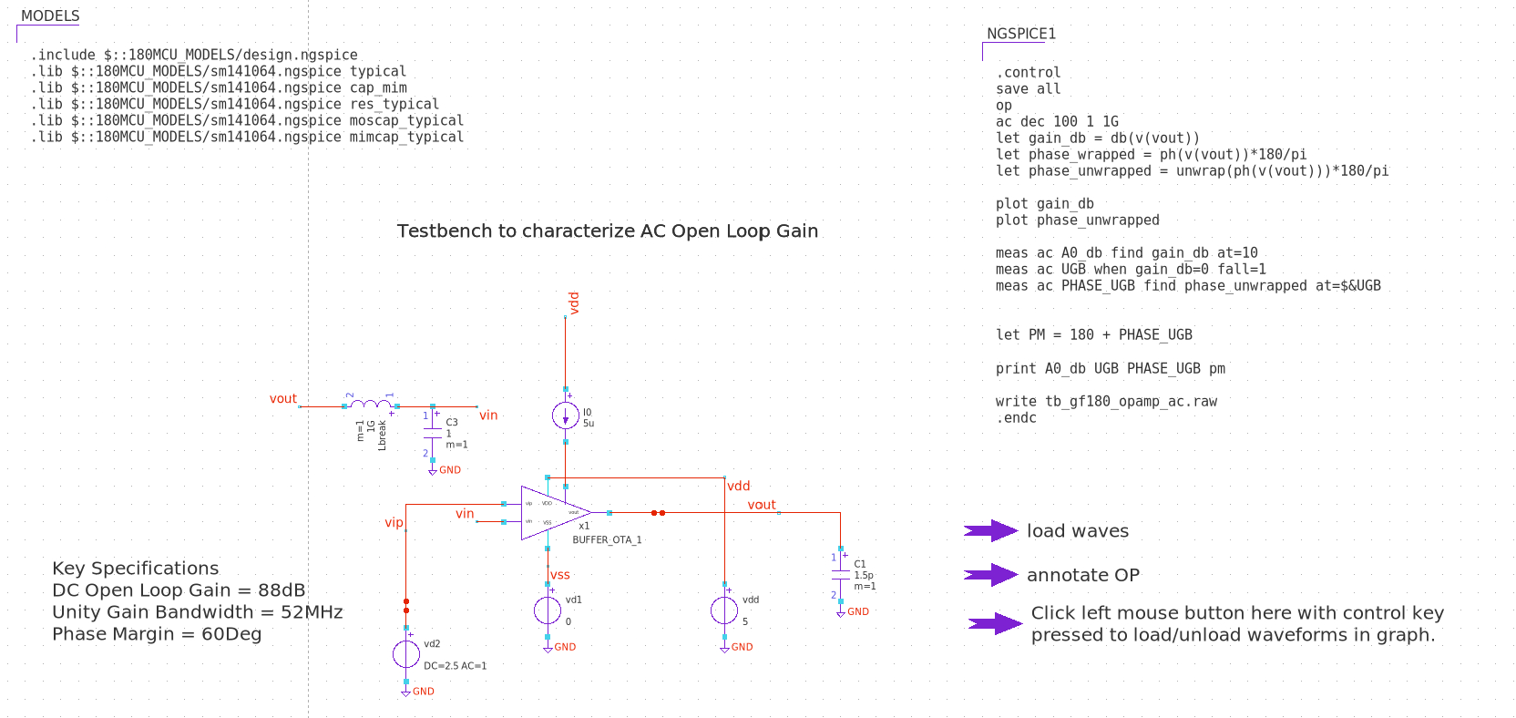
[picture p52: figure]

## AC Simulation Results

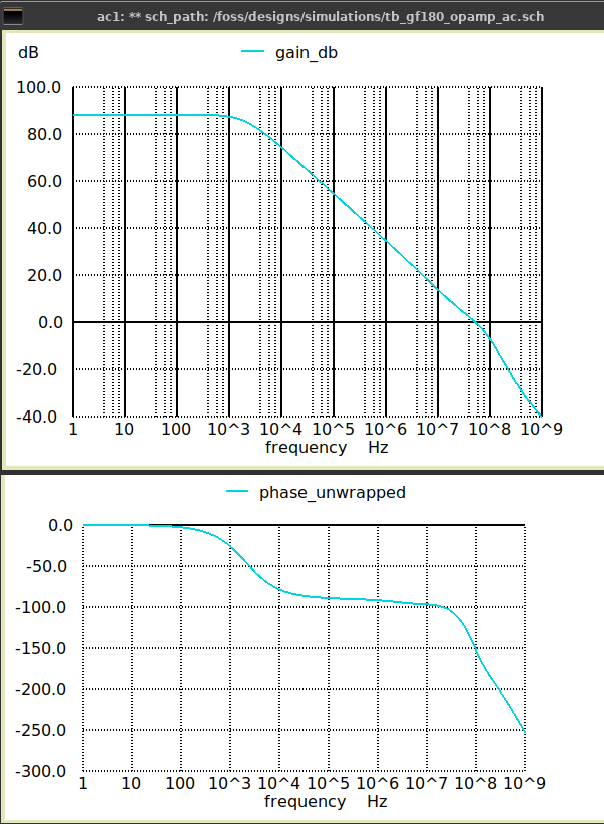
[picture p53: figure]

88dB

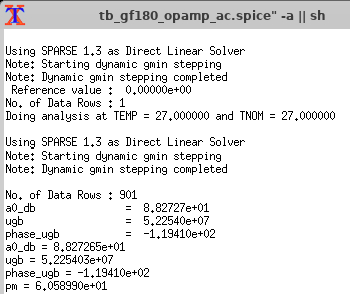
[picture p54: figure]

Typical Corner Results:
DC Open Loop Gain = 88.27dB
UGB = 52MHz
Phase Margin = 60.5̊

## Closed Loop Buffer Schematic

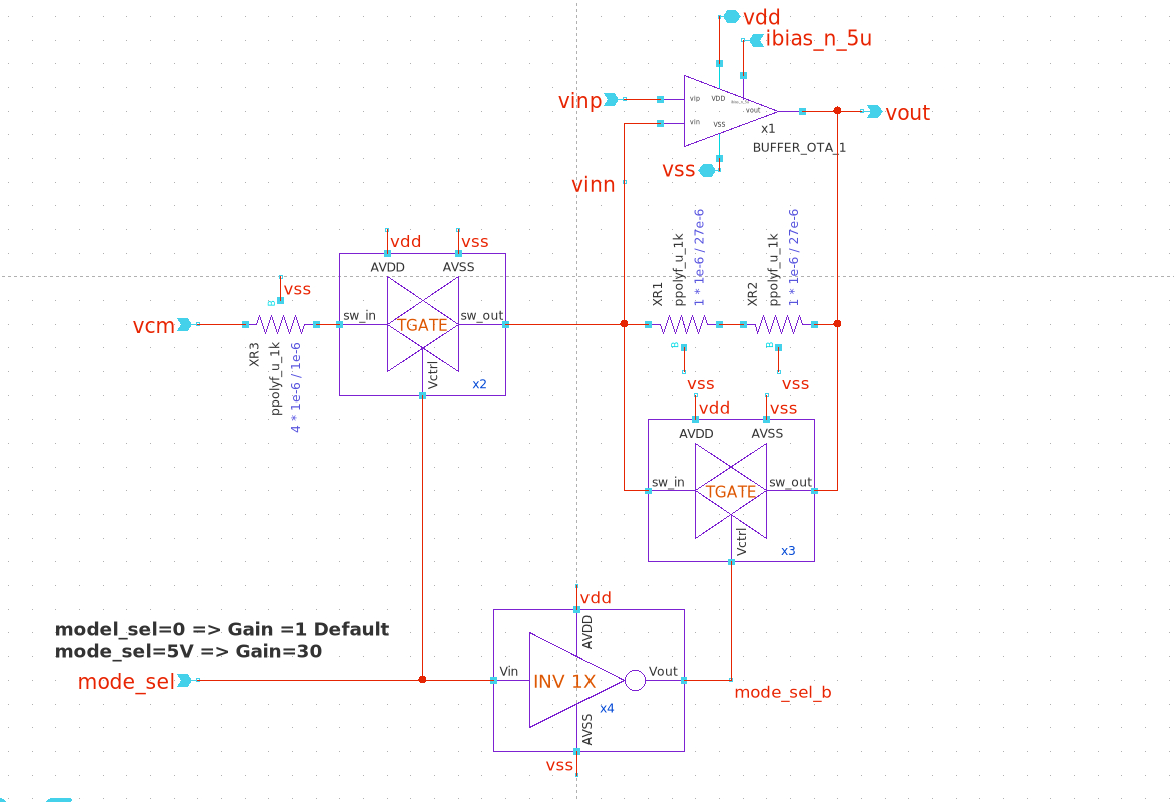
[picture p55: figure]

Programmable Gain
Mode_sel = 0, Gain = 1(Default)
Mode_sel = 1, Gain = 30

## Closed Loop Testbench

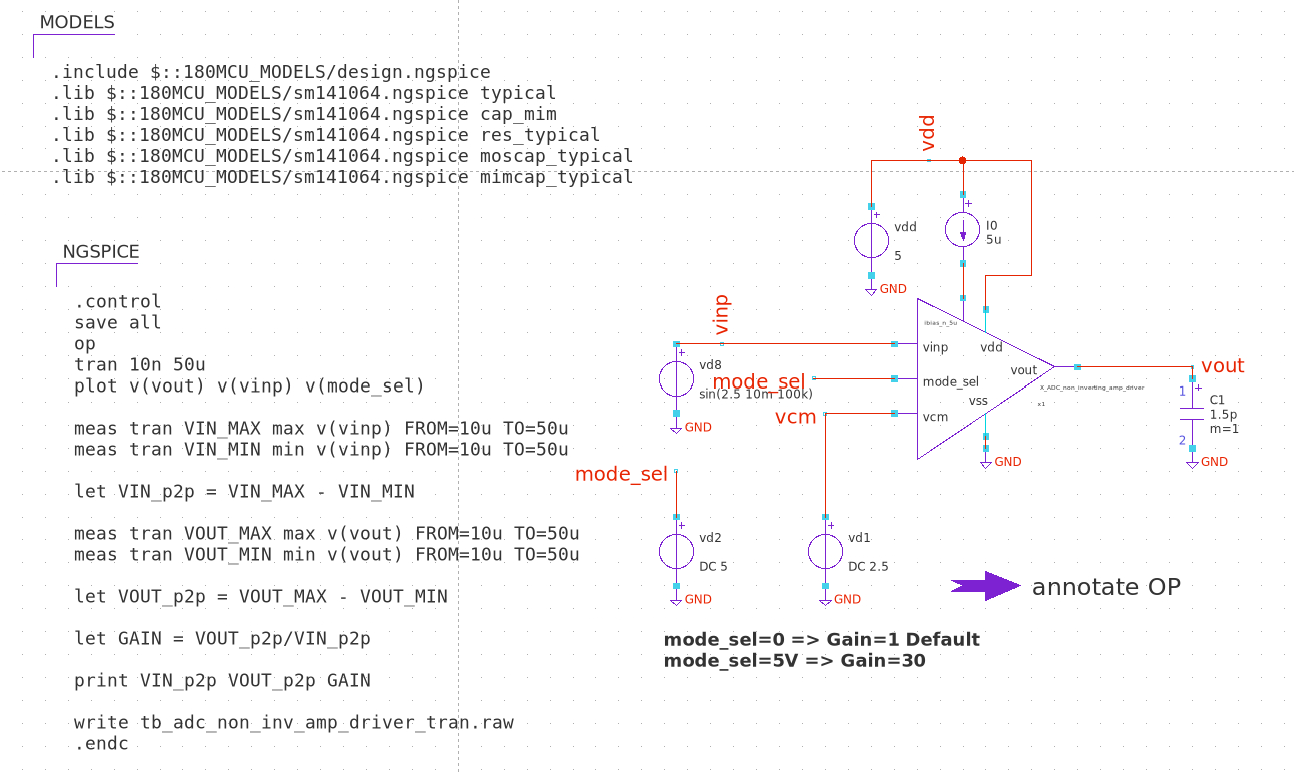
[picture p56: figure]

## Transient Simulation Results, Mode_sel = 0, Gain = 1

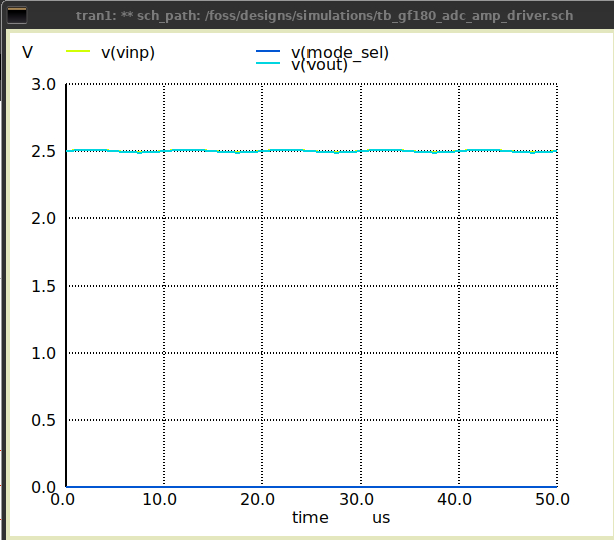
[picture p57: figure]
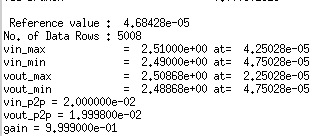
[picture p58: figure]

Unity Gain mode
Vin = 20mV p2p

Mode_sel = 0

## Transient Simulation Results, Mode_sel = 1, Gain = 30

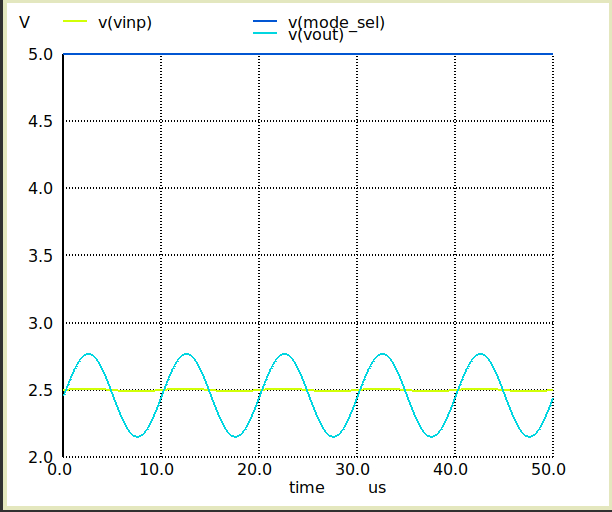
[picture p59: figure]

Mode_sel = 1

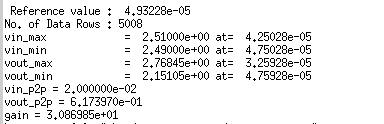
[picture p60: figure]

Unity Gain mode
Vin = 20mV p2p
Vout = 612mV p2p
Gain = 30.86

## Summary

No. | Parameter | Value | Simulations Results
1. | DC Open Loop Gain | > 70dB | 88.27dB
2. | Unity Gain Bandwidth | > 30MHz | 52MHz
3. | Phase Margin | > 60̊ | 60.5̊
4. | Current Consumption | | 435uA
5. | Settling Time | | 30ns
