shetnehal/Chipalooza_CuriousIC_BMS/(commit log)

2026-10-07 Remove Track section from README
2026-10-08 Revise design schematics description in README
    Updated the description of the design schematics section.
